XinArkh/Machine_Design_Project/说明及报告/减速器-武鑫.docx

浙江大学课程设计

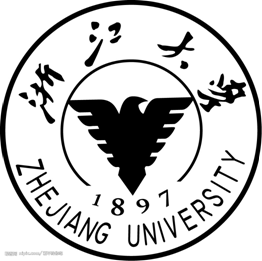
[picture p1: figure]
图片3

课程名称： | 机械设计课程设计（甲）
学生姓名： | 武 鑫
专 业： | 机械电子工程
学 号： | 315010xxxx

2018.03—04

# 1、 设计任务书

## (1) 目标

设计一用于胶带输送机卷筒的传动装置。

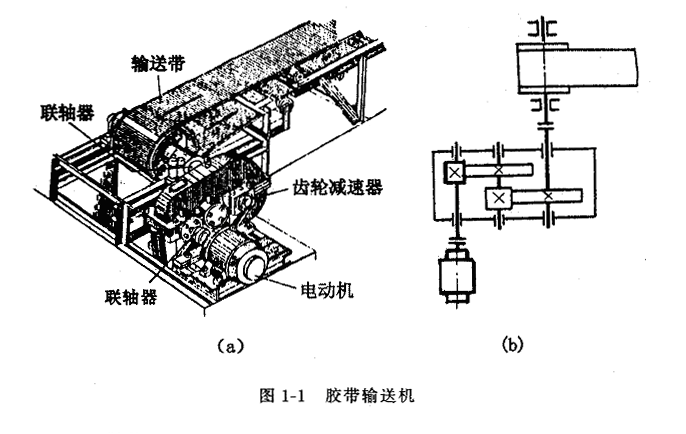
[picture p2: figure]
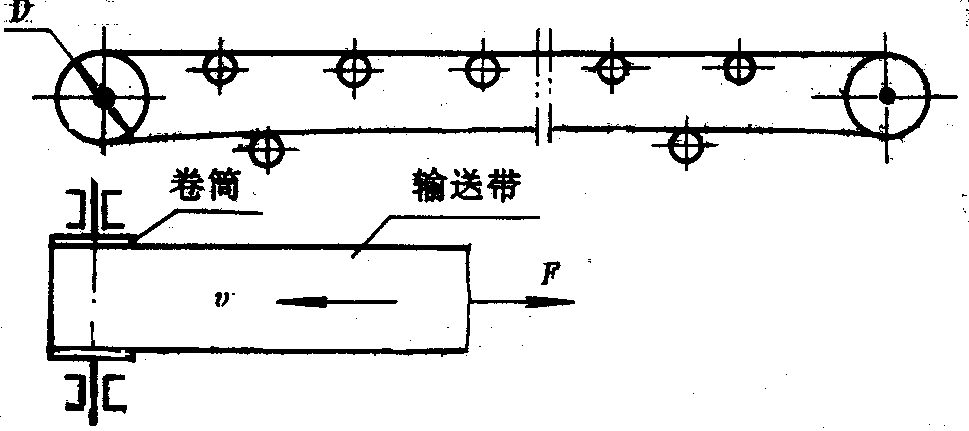
[picture p3: figure]

## (2) 原始条件和数据

输送机两班连续单向运转，载荷平稳，空载启动，室内工作，有粉尘；使用期限10年，大修期3年。该机动力来源为三相交流电，在中等规模机械厂小批量生产。输送带允许速度误差为±5％。

输送带工作拉力2400N，输送带速度1.2m/s，卷筒直径300mm。

# 2、 整体分析与思路

一般的工作机通常由原动机、传动装置和工作装置三个基本部分组成。设计一个用于传送带工作轴的转的装置，即是为电动机和输送机设计一个减速装置。

实现两回转轴之间传动的常用机构有很多种，譬如普通平带、V带传动，链传动，普通齿轮转动，涡轮蜗杆传动以及行星轮传动等。不同的方案又有不同的特点，以实现不同的工作需求。譬如带传动可以实现大跨度的传动，但承载能力较差；链传动平均传动比准确，但运转不均匀，有冲击；涡轮蜗杆传动比大，但承载能力及效率均不如齿轮等等。

在本减速器的设计方案中，选择了两级齿轮传动的传动方案。对于两级齿轮的传动方案，在齿轮布置的型式上也有很多选择，如展开式、分流式、同轴线式等。

本减速器参考了《机械设计课程设计（第四版）》的相关内容，选用两级展开式齿轮减速器，是两级减速器中应用最为广泛的一种。其中齿轮相对于轴承不对称，因此要求轴具有较大的刚度，伸出轴上的齿轮常布置在远离伸出轴的一边，以减少因弯曲变形所引起的载荷沿齿宽分布不均匀现象，输入轴与输出轴分布于减速器的两边。减速器高速级使用一对斜齿轮，低速级使用一对直齿轮，用于载荷较为平稳的场合，以达到减速传动的要求。

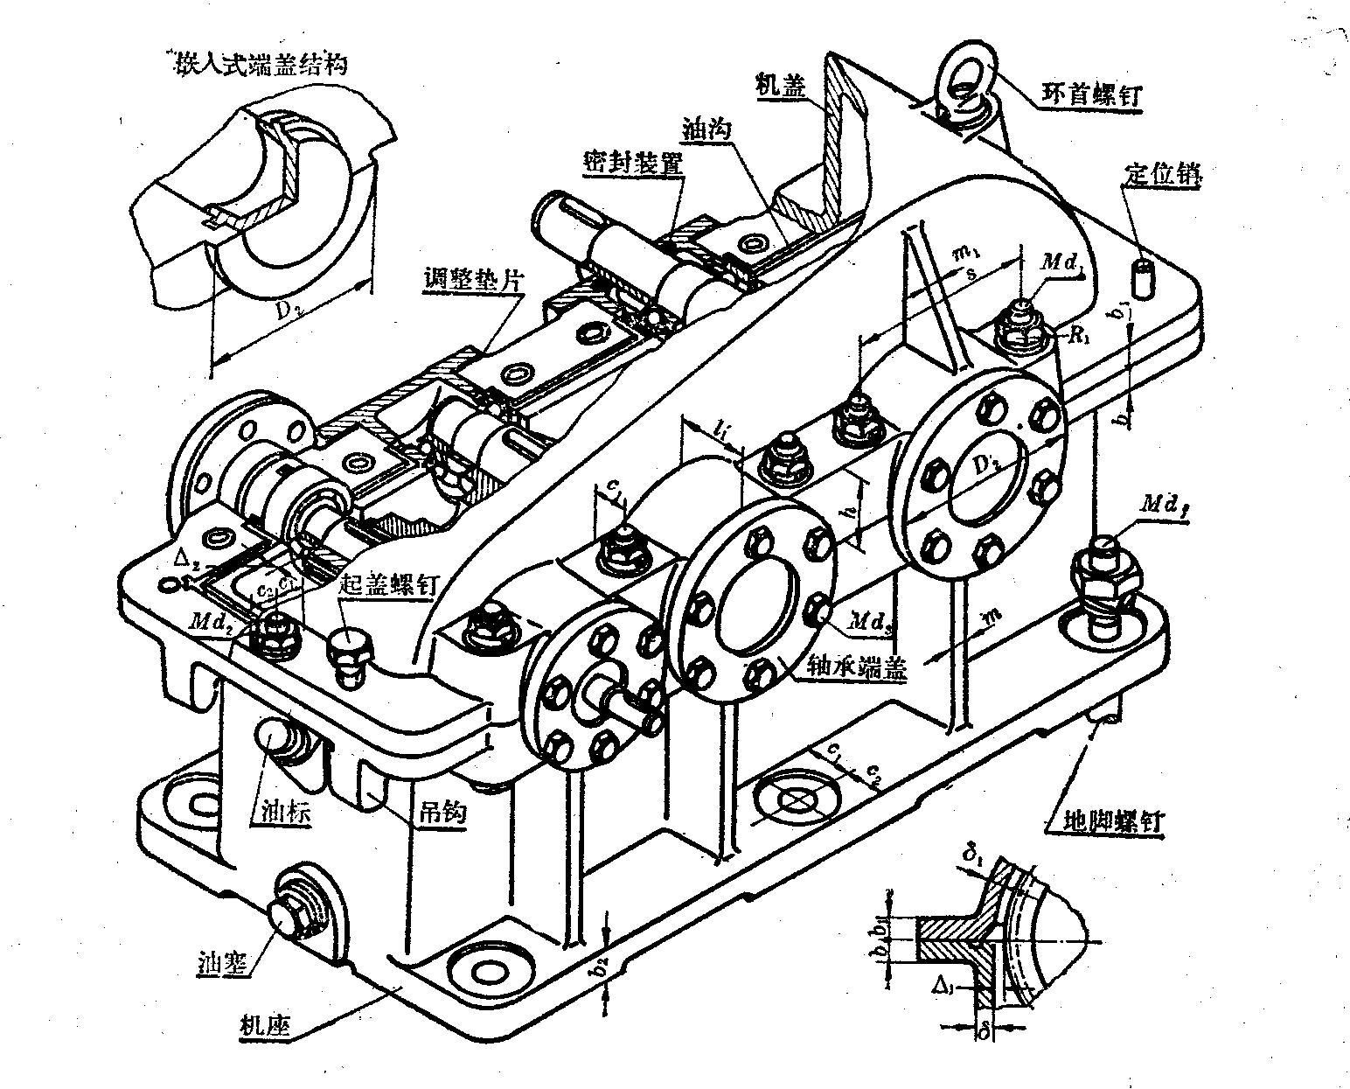
[picture p4: figure]

# 3、 设计说明书

设计内容 | 计算及说明 | 结果
| (1) 传动方案设计

### 1.布局

### 2.选择电动机

（1）选择电动机类型

（2）确定电动机功率，选择型号

### 3．传动比计算与分配

（1）总传动比

（2）分配各级传动比

### 4.计算传动装置的运动和动力参数

（1）各轴转速

（2）各轴输入功率

（3）各轴输入转矩

采用二级圆柱齿轮减速器。

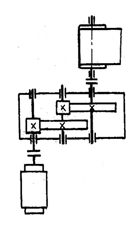
[picture p5: figure]

题设条件中得知，点击动力来源为三相交流电，则采用Y系列三相交流异步电机。

传动带平带开式传动效率为 η_带 =0.98 ，联轴器效率定为 η_联 =0.99 ，（一对）轴承的效率定为 η_轴 =0.99 ，8级精度的一般齿轮传动（稀油润滑）效率为 η_轮 =0.97 。

η_w =η_带 ×η_联 =0.97

P_w =(F_w ·v_w)/(1000η_w)=2.97 kW

η=η_联^2 ×η_轴^3 ×η_轮^2 =0.89

P_0 =(P_w)/η=3.32 kW

常用电动机同步转速有1000r/min和1500r/min两种，考虑到转速较小，可以是传动比较小，从而减小减速其整体尺寸，选用同步转速1000r/min的电动机。

查[2]表8-184知，符合条件的电动机中最合适的型号为Y132M1-6，其相关参数如下表所示：

型号 | Y132M1-6
额定功率（kW） | 4.0
同步转速（r/min） | 1000
满载转速（r/min） | 960
堵转转矩/额定转矩 | 2.0
最大转矩/额定转矩 | 2.2
质量（kg） | 73
转轴直径（mm） | 38

n_w =(v_w)/(π·D)=76.39 r/min

i=(n_m)/(n_w)=12.57

查表知，普通齿轮传动比一般为3~5，则所选两级展开式圆柱齿轮减速器可以满足转动比要求。

i=i_f ×i_s ，为使减速器外廓尺寸协调，相差不悬殊，试取 i_s =3 ，则 i_f =i/(i_s)=4.19 。验证 (i_f)/(i_s)=1.40 ，满足 i_f ≈(1.3~1.6)i_s ，分配合理。

两联轴器处 i_(0-I) =1 ， i_(III-w) =1 。

n_I =(n_m)/(i_(0-I))=960 r/min

n_(II) =(n_I)/(i_(I-II))=229.12 r/min

n_(III) =(n_(II))/(i_(II-III))=76.37 r/min

n_w =(n_(III))/(i_(III-w))=76.37 r/min

P_I =P_0 ·η_(0-I) =P_0 ·η_联 =3.29 kW

P_(II) =P_I ·η_(I-II) =P_I ·η_轴 ·η_轮 =3.16 kW

P_(III) =P_(II) ·η_(II-III) =P_(II) ·η_轴 ·η_轮 =3.03 kW

P_w =P_(III) ·η_(III-w) =P_(III) ·η_轴 ·η_联 =2.97 kW

T_0 =9550(P_0)/(n_m)=33.03 N·m

T_I =9550(P_I)/(n_I)=32.73 N·m

T_(II) =9550(P_(II))/(n_(II))=131.71 N·m

T_(III) =9550(P_(III))/(n_(III))=378.90 N·m

T_w =9550(P_w)/(n_w)=371.40 N·m

将以上算得的运动和动力参数列表如下：

采用Y系列三相交流异步电机

η_带 =0.98

η_联 =0.99

η_轴 =0.99

η_轮 =0.97

η_w =0.97

P_w =2.97 kW

η=0.89

P_0 =3.32 kW

选择额定功率P=4.0kW的电机，型号为Y132M1-6

n_w =76.39 r/min

i=12.57

i_f =4.19

i_s =3

i_(0-I) =1

i_(III-w) =1

n_I =960 r/min

n_(II) =229.12 r/min

n_(III) =76.37 r/min

n_w =76.37 r/min

P_I =3.29 kW

P_(II) =3.16 kW

P_(III) =3.03 kW

P_w =2.97 kW

T_0 =33.03 N·m

T_I =32.73 N·m

T_(II) =131.71 N·m

T_(III) =378.90 N·m

T_w =371.40 N·m

轴名 参数 | 电动机轴 | I轴 | | II轴 | | III轴 | | 工作轴
转速n（r/min） | 960 | 960 | | 229.12 | | 76.37 | | 76.37
功率P（kW） | 3.32 | 3.29 | | 3.16 | | 3.03 | | 2.97
转矩T（N·m） | 33.03 | 32.73 | | 131.71 | | 378.90 | | 371.40
传动比i | 1 | | 4.19 | | 3 | | 1
效率 η | 0.99 | | 0.96 | | 0.96 | | 0.98
| (2) 齿轮传动设计计算

### 1.高速级齿轮传动设计

（1）齿轮材料选择

（2）按齿面接触强度设计公式计算

1 小齿轮传递的转矩
2 选择齿轮齿数
3 确定齿轮精度
4 系数选择
5 确定许用接触应力
6 计算小齿轮分度圆直径
7 计算中心距
8 计算螺旋角及模数
9 计算齿轮主要尺寸
10 验算圆周速度

（3）按齿面弯曲强度校核公式校核

1 确定复合齿形系数
2 确定许用弯曲应力
3 校核齿面弯曲强度

（4）结构设计

### 2.低速级齿轮传动设计

（1）齿轮材料选择

（2）按齿面接触强度设计公式计算

1 小齿轮传递的转矩
2 选择齿轮齿数
3 确定齿轮精度
4 系数选择
5 确定许用接触应力
6 计算小齿轮分度圆直径
7 计算中心距
8 计算螺旋角及模数
9 计算齿轮主要尺寸
10 验算圆周速度

（3）按齿面弯曲强度校核公式校核

1 确定复合齿形系数
2 确定许用弯曲应力
3 校核齿面弯曲强度

（4）结构设计

考虑到减速器传动平稳性，高速级、低速级齿轮均采用斜齿圆柱齿轮。

小齿轮采用40MnB钢调质，大齿轮采用45钢正火。查阅[2]表6-5，得到两齿轮材料主要力学性能如下：

材料牌号 | 热处理方法 | 抗拉强度 σ_B (MPa) | 屈服极限 σ_s (MPa) | 硬度（HBS）
40MnB | 调质 | 735 | 490 | 241~286
45 | 正火 | 588 | 294 | 169~217

由于两齿轮齿面硬度范围均小于350HBS，即均属于软齿面齿轮，根据软齿面闭式齿轮传动中一般为齿面点蚀失效的特点，选择先按照齿面接触强度条件确定主要参数和传动尺寸，然后再按弯曲强度条件进行校核计算。

一对钢齿轮接触强度的设计公式：

d_1 ≥³√(（590/([σ])）^2 ·(u+1)/u·(KT_1)/(ψ_d)) (mm)

已求得

T_1 =32.73 (N·m)=32730 (N·mm)

齿数比 u=i_f =4.19 ，小齿轮齿数 z_1 =21 时， z_2 =uz_1 =88 ，恰好都是整数。

普通减速齿轮，精度选择8级，参考[2]表6-4，圆周速度不得大于 8 m/s 。

载荷平稳，非对称分布，参考[2]表6-6，载荷综合系数 K=1.3 ，参考[2]表6-9，齿宽系数 ψ_d =0.9 。

高速级齿轮的许用应力的数值大小应该是一对齿轮中较小的许用应力值。

许用应力计算公式：

[σ_H ]=(σ_(Hlim))/(S_(Hmin))

参考[2]图6-28， σ_(Hlim1) =720MPa, σ_(Hlim2) =460MPa ；

参考[2]表6-8， S_(Hmin) =1 。

将查得数据代入上式，得 [σ_(H1) ]=720MPa, [σ_(H2) ]=460MPa ，所以 [σ_H ]=[σ_(H1) ]=460MPa 。

d_1 ≥³√(（590/460）^2 ·(4.19+1)/4.19·(1.3×32730)/0.9)=45.84 (mm)

按照 d_1 =45.84 mm 初步计算中心距a：

a=(d_1)/2(1+u)=118.95 (mm)

对结果进行圆整，取 a=120 mm 。

螺旋角 β 常取 8°~20° ，这里初取 β=15° 。

齿轮模数：

m_n =(2acosβ)/(z_1 +z_2)=2.1268 (mm)

参考[2]表6-1，圆整取 m_n =2 mm 。

计算螺旋角 β ：

β=arccos(m_n (z_1 +z_2 ))/(2a)=24.72°

经多次尝试，发现在当前条件下很难找到 8°~20° 范围内的 β 角，经顾大强老师确认，考虑到 24.72° 没有偏离理想值太远，认为该值有效。最终选定 m_n =2 mm ， β=24.72° 。

分度圆直径：

d_1 =(m_n z_1)/(cosβ)=46.237 (mm)

d_2 =(m_n z_2)/(cosβ)=193.763 (mm)

中心距：

a=1/2(d_1 +d_2 )=120 (mm)

齿轮宽度：

b=ψ_d ·d_1 =41.613 (mm)

小齿轮齿宽比大齿轮齿宽大 5~10 mm ,则取 b_1 =47mm, b_2 =42mm 。强度计算中以 b_2 为准，即b =b_2 。

圆周速度：

v=(πd_1 n_I)/(60×1000)=2.324 (m/s)

满足8级精度的速度要求。

斜齿轮弯曲强度校核公式：

σ_F =(1.6KT_1 Y_(Fs))/(bd_1 m_n)≤[σ_F ] (MPa)

小齿轮：

z_(v1) =(z_1)/(cos^3 β)=28.02

大齿轮：

z_(v2) =(z_2)/(cos^3 β)=117.41

由[2]图6-30查得复合齿形系数 Y_(Fs1) =4.20, Y_(Fs2) =3.92 。

由[2]图6-31查得 σ_(Flim1) =530MPa ， σ_(Flim2) =360MPa 。

由[2]表6-8查得 S_(Fmin) =1 ，则：

[σ_(F1) ]=(σ_(Flim1))/(S_(Fmin))=530 (MPa)

[σ_(F2) ]=(σ_(Flim2))/(S_(Fmin))=360 (MPa)

σ_(F1) =(1.6KT_1 Y_(Fs1))/(bd_1 m_n)=73.62<[σ_(F1) ]=530 (MPa)

σ_(F2) =σ_(F1) (Y_(Fs2))/(Y_(Fs1))=68.71<[σ_(F2) ]=360 (MPa)

校核计算安全。

小齿轮做成齿轮轴；大齿轮做成腹板式齿轮，采用锻造齿轮。

同样选择40MnB调质钢和45正火钢作为小齿轮和大齿轮的材质，相关力学性能同高速级部分表格所示。

先按照齿面接触强度条件确定主要参数和传动尺寸，然后再按弯曲强度条件进行校核计算，理由同高速级部分。

一对钢齿轮接触强度的设计公式：

d_1 ≥³√(（590/([σ])）^2 ·(u+1)/u·(KT_1)/(ψ_d)) (mm)

已求得

T_1 =131.71(N·m)=131710 (N·mm)

齿数比 u=i_s =3 ，选择小齿轮齿数 z_1 =24 ， z_2 =uz_1 =72 。

普通减速齿轮，精度选择8级，参考[2]表6-4，圆周速度不得大于 8 m/s 。

载荷平稳，非对称分布，参考[2]表6-6，载荷综合系数 K=1.3 ，参考[2]表6-9，齿宽系数 ψ_d =0.9 。

低速级齿轮的许用应力的数值大小应该是一对齿轮中较小的许用应力值。

许用应力计算公式：

[σ_H ]=(σ_(Hlim))/(S_(Hmin))

参考[2]图6-28， σ_(Hlim1) =720MPa, σ_(Hlim2) =460MPa ；

参考[2]表6-8， S_(Hmin) =1 。

将查得数据代入上式，得 [σ_(H1) ]=720MPa, [σ_(H2) ]=460MPa ，所以 [σ_H ]=[σ_(H1) ]=460MPa 。

d_1 ≥³√(（590/460）^2 ·(3+1)/3·(1.3×131710)/0.9)=74.73 (mm)

按照 d_1 =74.73 mm 初步计算中心距a：

a=(d_1)/2(1+u)=149.46 (mm)

对结果进行圆整，取 a=150 mm 。

螺旋角 β 常取 8°~20° ，这里初取 β=15° 。

齿轮模数：

m_n =(2acosβ)/(z_1 +z_2)=3.0185 (mm)

参考[2]表6-1，圆整取 m_n =3 mm 。

计算螺旋角 β ：

β=arccos(m_n (z_1 +z_2 ))/(2a)=16.26°

分度圆直径：

d_1 =(m_n z_1)/(cosβ)=75.000 (mm)

d_2 =(m_n z_2)/(cosβ)=225.000 (mm)

中心距：

a=1/2(d_1 +d_2 )=150 (mm)

齿轮宽度：

b=ψ_d ·d_1 =67.50 (mm)

小齿轮齿宽比大齿轮齿宽大 5~10 mm ,则取 b_1 =73mm, b_2 =68mm 。强度计算中以 b_2 为准，即b =b_2 。

圆周速度：

v=(πd_1 n_(II))/(60×1000)=0.900 (m/s)

满足8级精度的速度要求。

斜齿轮弯曲强度校核公式：

σ_F =(1.6KT_1 Y_(Fs))/(bd_1 m_n)≤[σ_F ] (MPa)

小齿轮：

z_(v1) =(z_1)/(cos^3 β)=27.13

大齿轮：

z_(v2) =(z_2)/(cos^3 β)=81.38

由[2]图6-30查得复合齿形系数 Y_(Fs1) =4.10, Y_(Fs2) =3.93 。

由[2]图6-31查得 σ_(Flim1) =530MPa ， σ_(Flim2) =360MPa 。

由[2]表6-8查得 S_(Fmin) =1 ，则：

[σ_(F1) ]=(σ_(Flim1))/(S_(Fmin))=530 (MPa)

[σ_(F2) ]=(σ_(Flim2))/(S_(Fmin))=360 (MPa)

σ_(F1) =(1.6KT_1 Y_(Fs1))/(bd_1 m_n)=73.41<[σ_(F1) ]=530(MPa)

σ_(F2) =σ_(F1) (Y_(Fs2))/(Y_(Fs1))=70.37<[σ_(F2) ]=360(MPa)

校核计算安全。

小齿轮做成齿轮轴；大齿轮做成腹板式齿轮，采用锻造齿轮。

小齿轮：40MnB钢调质

大齿轮：45钢正火

u=i_f =4.19

z_1 =21

z_2 =88

K=1.3

ψ_d =0.9

[σ_H ]=460MPa

d_1 ≥45.84 mm

m_n =2 mm

β=24.72°

d_1 =46.237 mm

d_2 =193.763 mm

a=120 mm

b_1 =47 mm

b=b_2 =42 mm

v=2.324 m/s

z_(v1) =28.02

z_(v2) =117.41

Y_(Fs1) =4.20

Y_(Fs2) =3.92

[σ_(F1) ]=530 MPa

[σ_(F2) ]=360 MPa

σ_(F1) <[σ_(F1) ]

σ_(F2) <[σ_(F2) ]

安全

齿轮1：齿轮轴

齿轮2：锻造腹板式齿轮

小齿轮：40MnB钢调质

大齿轮：45钢正火

u=i_s =3

z_1 =24

z_2 =72

K=1.3

ψ_d =0.9

[σ_H ]=460MPa

d_1 ≥74.73 mm

m_n =3 mm

β=16.26°

d_1 =75.000 (mm)

d_2 =225.000 (mm)

a=150 (mm)

b_1 =73mm

b=b_2 =68mm

v=0.900 m/s

z_(v1) =27.13

z_(v2) =81.38

Y_(Fs1) =4.10

Y_(Fs2) =3.93

[σ_(F1) ]=530 MPa

[σ_(F2) ]=360 MPa

σ_(F1) <[σ_(F1) ]

σ_(F2) <[σ_(F2) ]

安全

齿轮3：锻造腹板式齿轮

齿轮4：锻造腹板式齿轮
| (3) 轴的结构设计计算及校核

### 1. 齿轮受力计算

（1）高速级

齿轮1

（2）低速级齿轮4

（3）中间级齿轮2、3

### 2. 中间轴结构设计计算及校核

（1）轴的材料选择

（2）按转矩估算最小直径

（3）轴的结构设计

1 轴承选择
2 轴的轴向尺寸确定

（4）轴承反力计算

（5）绘制弯矩图

1 水平弯矩图
2 垂直弯矩图
3 合成弯矩图

（6）绘制扭矩图

（7）绘制当量弯矩图

（8）校核危险截面处直径

（9）精确校核轴的疲劳强度

### 3. 高速轴结构设计计算及校核

（1）轴的材料选择

（2）按转矩估算最小直径

3）轴的结构设计

1 轴承选择
2 轴的轴向尺寸确定

（4）轴承反力计算

（5）绘制弯矩图

1 水平弯矩图
2 垂直弯矩图
3 合成弯矩图

（6）绘制扭矩图

（7）绘制当量弯矩图

（8）校核危险截面处直径

（9）精确校核轴的疲劳强度

### 4. 低速轴结构设计计算及校核

（1）轴的材料选择

（2）按转矩估算最小直径

3）轴的结构设计

1 轴承选择
2 轴的轴向尺寸确定

（4）轴承反力计算

（5）绘制弯矩图

1 水平弯矩图
2 垂直弯矩图
3 合成弯矩图

（6）绘制扭矩图

（7）绘制当量弯矩图

（8）校核危险截面处直径

（9）精确校核轴的疲劳强度

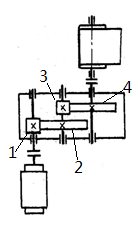
[picture p6: figure]

圆周力：

F_(t1) =(2T_I)/(d_1)=1.416(kN)

径向力：

F_(r1) =(F_(t1) tanα)/(cosβ)=0.567(kN)

轴向力：

F_(a1) =F_(t1) tanβ=0.652(kN)

F_(t4) =(2T_(III))/(d_4)=3.368(kN)

F_(r4) =(F_(t4) tanα)/(cosβ)=1.277(kN)

F_(a4) =F_(t4) tanβ=0.982(kN)

齿轮2：

F_(t2) =F_(t1) =1.416(kN)

F_(r2) =F_(r1) =0.567(kN)

F_(a2) =F_(a1) =0.652(kN)

齿轮3：

F_(t3) =F_(t4) =3.368(kN)

F_(r3) =F_(r4) =1.277(kN)

F_(a3) =F_(a4) =0.982(kN)

减速器功率不大，转速较低，无特殊要求，故选最常用的45号钢并做正火处理。

根据[2]表12-1查得：

硬度（HBS） | 170~217
抗拉强度 σ_B (MPa) | 600
屈服极限 σ_S (MPa) | 300
弯曲疲劳极限 σ_(-1) (MPa) | 240
剪切疲劳极限τ_(-1) (MPa) | 140

根据[2]表12-2，取 C=118 ，代入公式：

d≥C³√(P/n)=28.298(mm)

考虑到键槽对轴的削弱作用，圆整为 d_(min) =30mm 。

根据估算所得直径、轮毂宽及安装情况等条件，对轴的结构及尺寸进行草图设计。

轴承同时承受径向力和轴向力，采用一对角接触球轴承；考虑到轴承内径需不小于 d_(min) =30mm 。查[2]表8-158，选择7207AC型（GB/T292-1994）角接触球轴承，其主要几何参数如下：

内径d（mm） | 外径D（mm） | 宽度B（mm）
35 | 72 | 17

两端的轴承都用套筒定位和固定。

轴与齿轮选用平键连接。根据减速器的内壁到齿轮和轴承端面的距离，参考设计手册中有关经验数据，轴承跨距为160mm,将轴的结构尺寸初步取定如图所示：

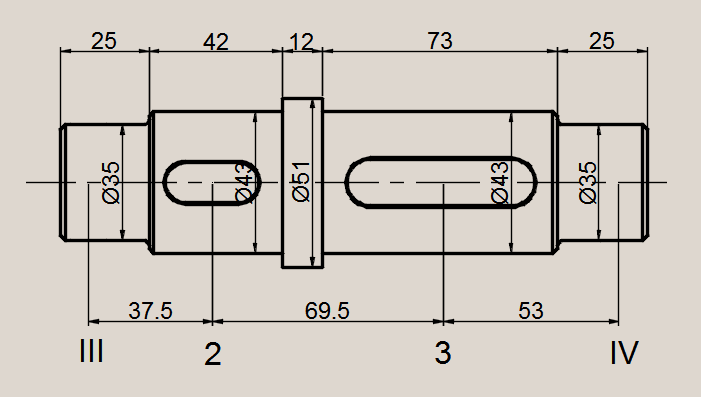
[picture p7: figure]

水平面：

R_(IIIH) =(-F_(a2) (d_2)/2+122.5F_(r2) -F_(a3) (d_3)/2-53F_(r3))/160=-0.614(kN)

R_(IVH) =(F_(a3) (d_3)/2-107F_(r3) +F_(a2) (d_2)/2+37.5F_(r2))/160=-0.096(kN)

垂直面：

R_(IIIV) =(122.5F_(t2) +53F_(t3))/160=2.200(kN)

R_(IVV) =(107F_(t3) +37.5F_(t2))/160=2.584(kN)

M_(2H)^(') =37.5R_(IIIH) =-23.019(N·m)

M_(2H)^('') =69.5F_(r3) -F_(a3) (d_3)/2+122.5R_(IVH) =40.148(N·m)

M_(3H)^(') =53R_(IVH) =-5.096(N·m)

M_(3H)^('') =-69.5F_(r2) +F_(a2) (d_2)/2+107R_(IIIH) =-41.921(N·m)

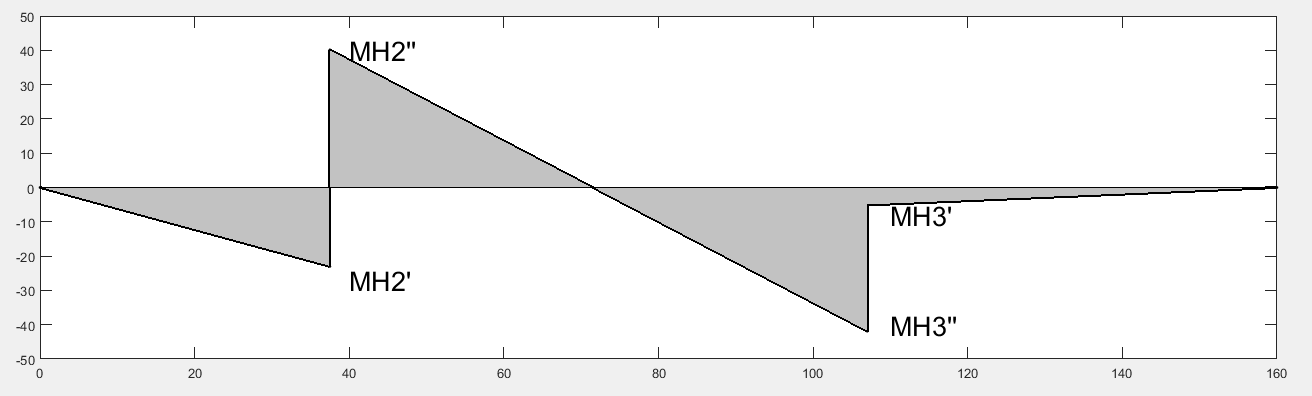
[picture p8: figure]

M_(2V) =37.5R_(IIIV) =82.492(N·m)

M_(3V) =53R_(IVV) =136.964(N·m)

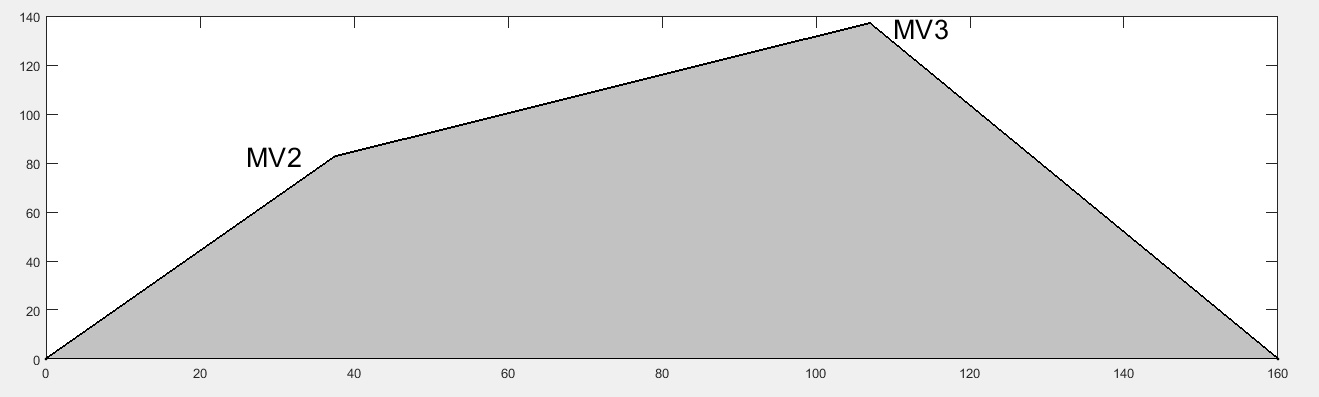
[picture p9: figure]

M_2^(') =√(M_(2H)^(') ^2 +M_(2V)^() ^2)=85.643(N·m)

M_2^('') =√(M_(2H)^('') ^2 +M_(2V)^() ^2)=91.742(N·m)

M_3^(') =√(M_(3H)^(') ^2 +M_(3V)^() ^2)=137.059(N·m)

M_3^('') =√(M_(3H)^('') ^2 +M_(3V)^() ^2)=143.236(N·m)

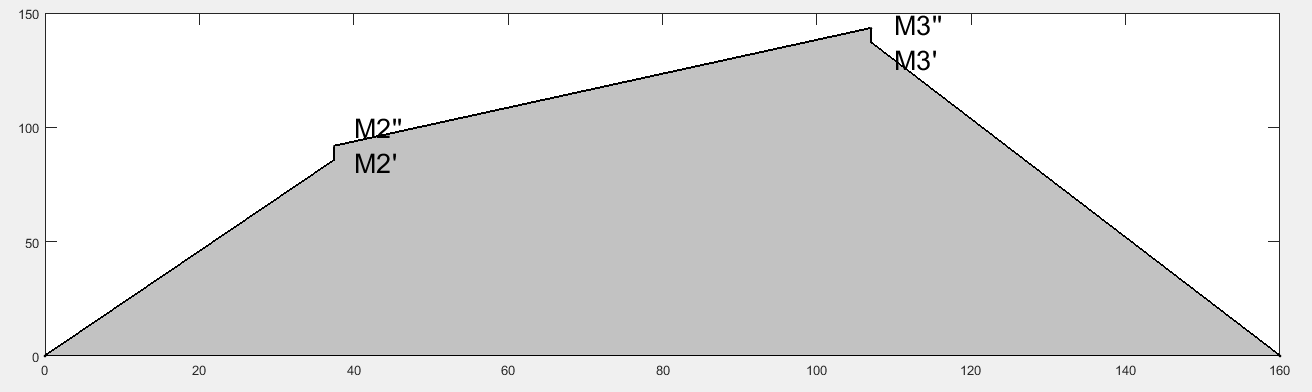
[picture p10: figure]

已求得轴II所受扭矩 T_2 =131.71N·m 。

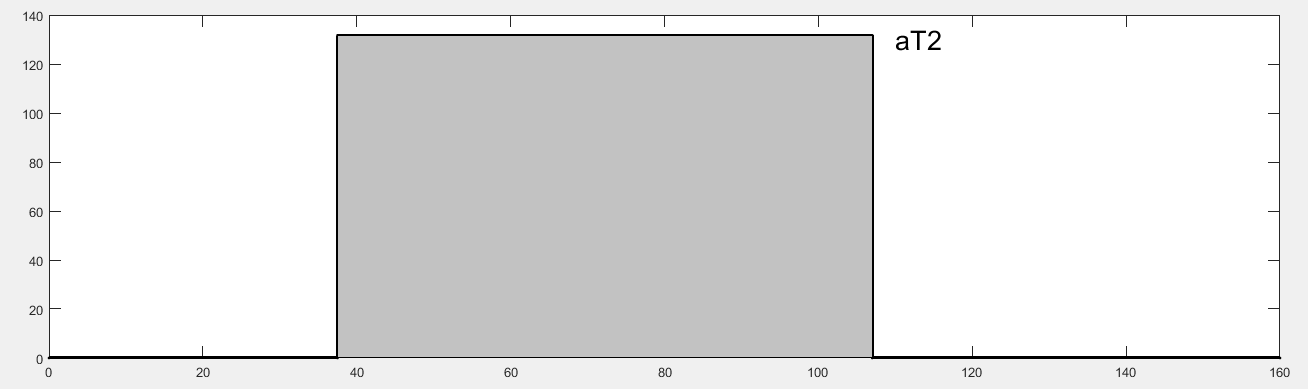
[picture p11: figure]

已知 σ_B =600MPa ，由[2]表12-3查得 [σ_(-1) ]_b =55MPa ， [σ_0 ]_b =95MPa ，则 α=55/95≈0.58 。

αT_2 =76.392(N·m)

M_(2e)^(') =√(M_2^(') ^2 +(αT_2 )^2)=114.763(N·m)

M_(2e)^('') =√(M_2^('') ^2 +(αT_2 )^2)=119.383(N·m)

M_(3e)^(') =√(M_3^(') ^2 +(αT_2 )^2)=156.910(N·m)

M_(3e)^('') =√(M_3^('') ^2 +(αT_2 )^2)=162.334(N·m)

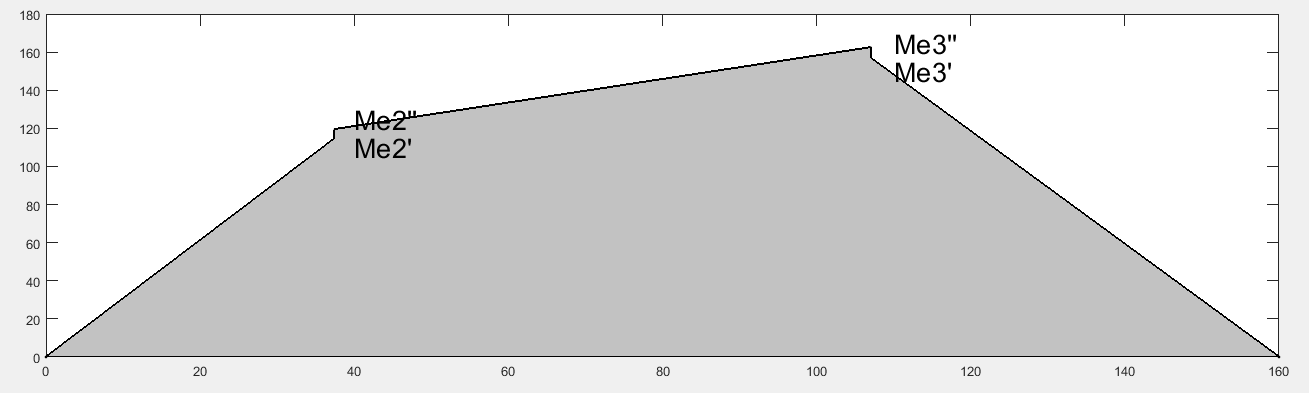
[picture p12: figure]

d_3 ≥³√((M_(3e)^(''))/(0.1[σ_(-1) ]_b))=30.904(mm)

直径条件（35mm）满足要求，强度足够。如所选轴承和键联接等经计算、确认寿命和强度均能满足，则以上轴的结构设计无需修改。

危险截面（齿轮3）处：

σ_a =(M_3^(''))/W=3.460(MPa)

σ_m =0

τ_a =τ_m =T/(2W_T)=0.795(MPa)

轴的弯曲等效系数 ψ_σ =0.2 ，剪切等效系数 ψ_τ =0.1 。

查表[2]12-4得 k_σ =1.76 ， k_τ =1.54 , ε_σ =0.81 ， ε_τ =0.76 。查表[2]12-8得 β=0.95 。取寿命系数 K_N =1 ， [S]=1.5 。

S_σ =(K_N σ_(-1))/((k_σ)/(ε_σ β)σ_a +ψ_σ σ_m)=30.33

S_τ =(K_N τ_(-1))/((k_τ)/(ε_τ β)τ_a +ψ_τ τ_m)=78.82

S=(S_σ S_τ)/(√(S_σ ^2 +S_τ ^2))=28.30>1.5

安全。

减速器功率不大，转速较低，无特殊要求，故选最常用的45号钢并做正火处理。

钢材硬度和相关力学参数已在中间轴部分列出。

根据[2]表12-2，取 C=118 ，代入公式：

d≥C³√(P/n)=17.79(mm)

考虑到键槽对轴的削弱作用，圆整为 d_(min) =20mm 。

根据估算所得直径、轮毂宽及安装情况等条件，对轴的结构及尺寸进行草图设计。

轴承同时承受径向力和轴向力，采用一对角接触球轴承；考虑到轴承内径需不小于 d_(min) =20mm 。查[2]表8-158，选择7205AC型（GB/T292-1994）角接触球轴承，其主要几何参数如下

内径d（mm） | 外径D（mm） | 宽度B（mm）
25 | 52 | 15

一端的轴承用套筒固定，另一端用轴肩固定。

选用齿轮轴。根据减速器的内壁到齿轮和轴承端面的距离，参考设计手册中有关经验数据，轴承跨距为160mm,将轴的结构尺寸初步取定如图所示：

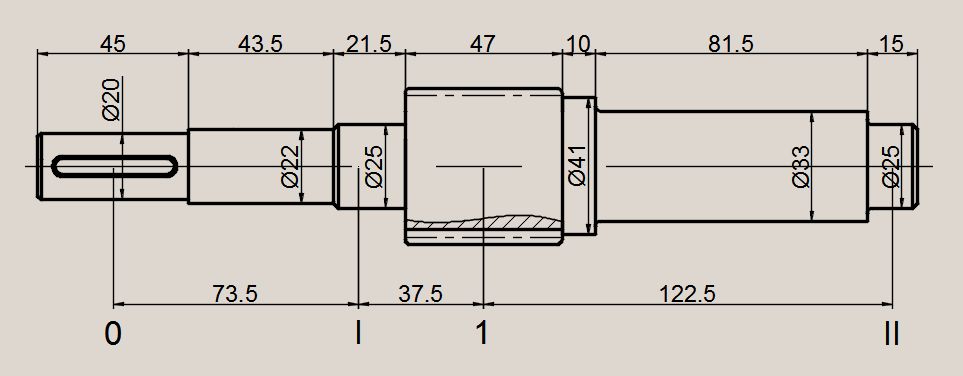
[picture p13: figure]

水平面：

R_(IH) =(F_(a1) (d_1)/2+112.5F_(r1))/160

=0.497(kN)

R_(IIH) =(-F_(a1) (d_1)/2+47.5F_(r1))/160=0.070(kN)

垂直面：

R_(IV) =(-112.5F_(t1))/160=-1.020(kN)

R_(IIV) =(-47.5F_(t1))/160=-0.396(kN)

M_(1H)^(') =47.5R_(IH) =23.619(N·m)

M_(1H)^('') =112.5R_(IIH) =8.546(N·m)

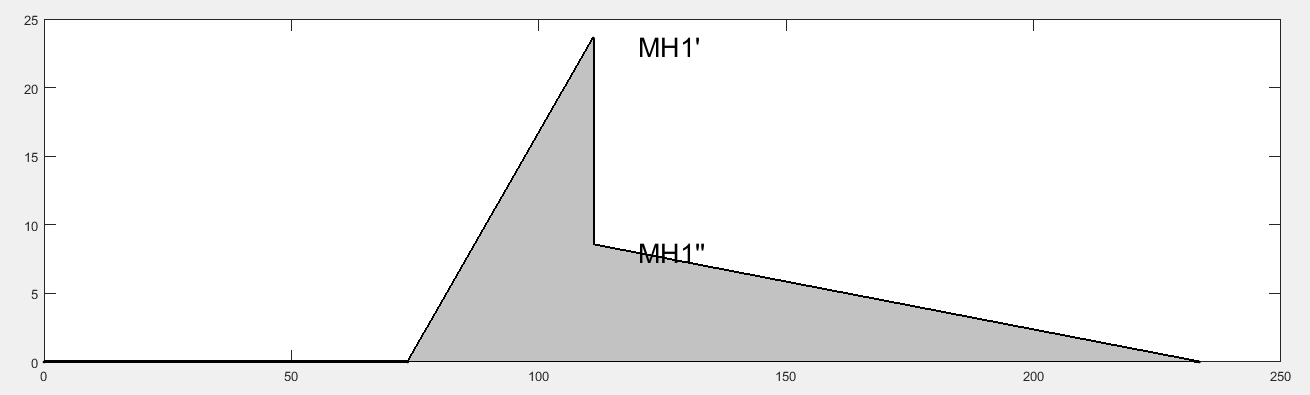
[picture p14: figure]

M_(1V) =47.5R_(IV) =-48.467(N·m)

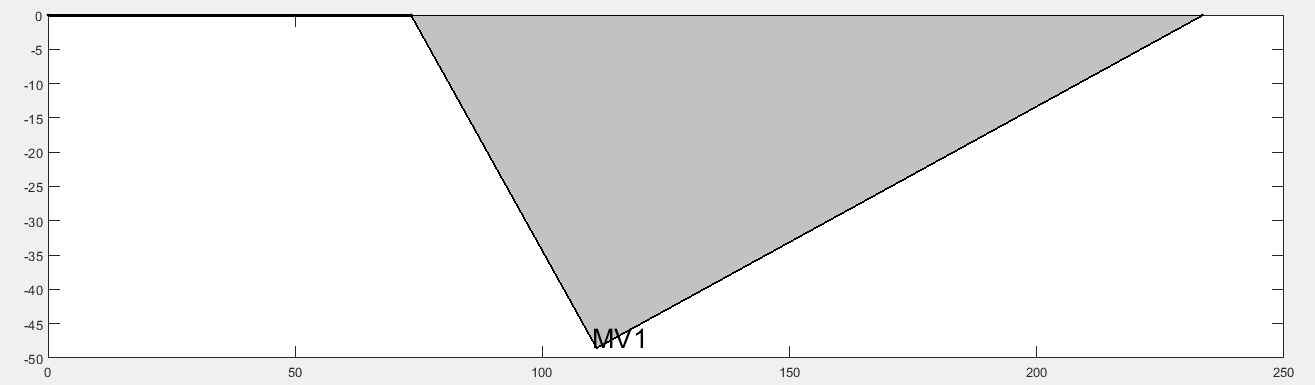
[picture p15: figure]

M_1^(') =√(M_H^(') ^2 +M_V^() ^2)=53.915(N·m)

M_1^('') =√(M_H^('') ^2 +M_V^() ^2)=49.214(N·m)

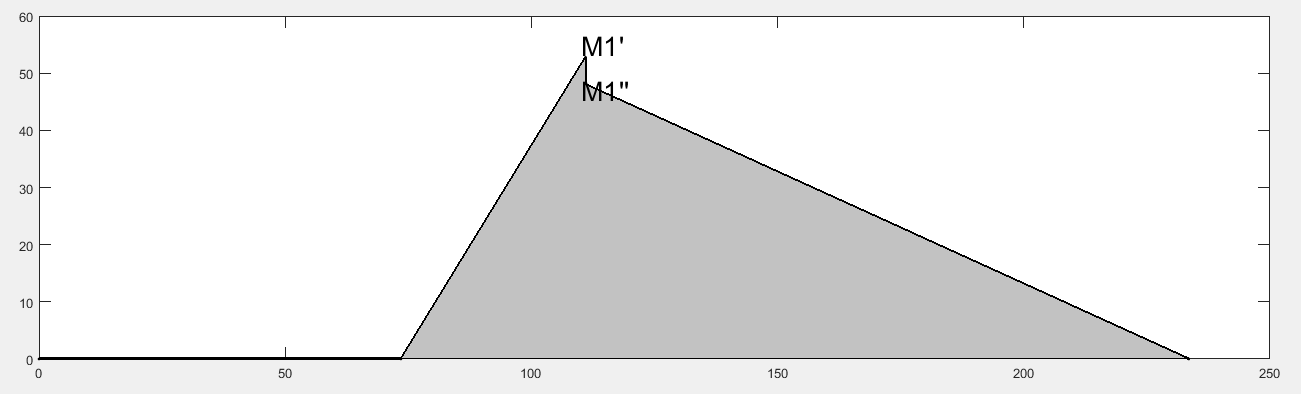
[picture p16: figure]

已求得轴I所受扭矩 T_1 =32.73N·m 。

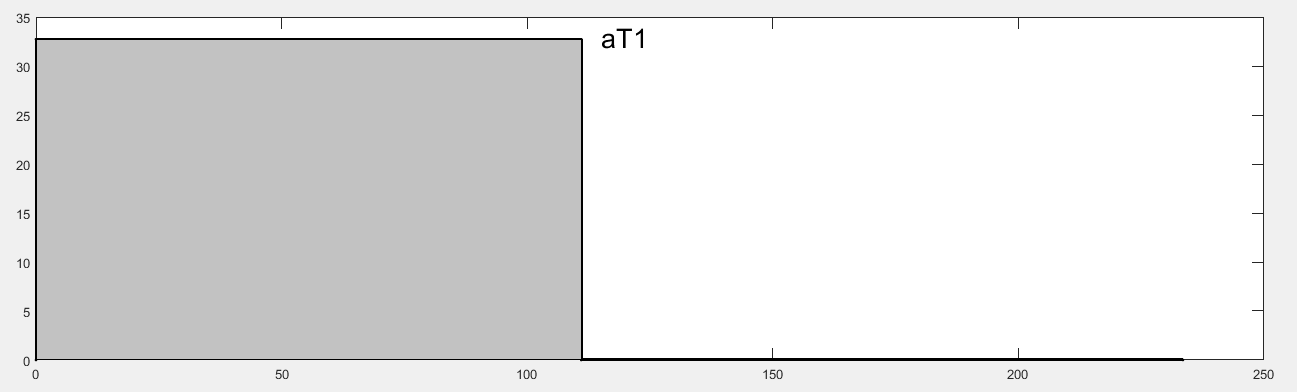
[picture p17: figure]

在中间轴部分已查得 σ_B =600MPa 、 [σ_(-1) ]_b =55MPa 、 [σ_0 ]_b =95MPa ，则 α=55/95≈0.58 。

αT_1 =18.983(N·m)

M_(1e)^(') =√(M_1^(') ^2 +(αT_1 )^2)=57.160(N·m)

M_(1e)^('') =M_1^('') =49.214(N·m)

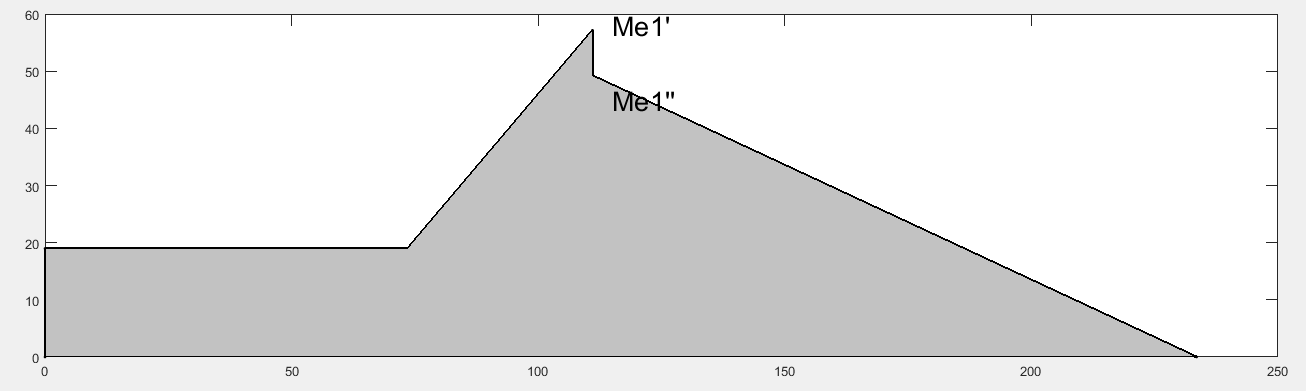
[picture p18: figure]

d_0 ≥³√((M_(0e)^(''))/(0.1[σ_(-1) ]_b))=15.113(mm)

d_1 ≥³√((M_(3e)^(''))/(0.1[σ_(-1) ]_b))=21.685(mm)

直径条件满足要求，强度足够。如所选轴承和键联接等经计算、确认寿命和强度均能满足，则以上轴的结构设计无需修改。

位置0处：

σ_a =σ_m =0

τ_a =τ_m =T/(2W_T)=10.424(MPa)

轴的弯曲等效系数 ψ_σ =0.2 ，剪切等效系数 ψ_τ =0.1 。

在中间轴部分已查得 k_σ =1.76、k_τ =1.54、ε_σ =0.81、ε_τ =0.76、β=0.95 。取寿命系数 K_N =1 ， [S]=1.5 。

S=S_τ =(K_N τ_(-1))/((k_τ)/(ε_τ β)τ_a +ψ_τ τ_m)=6.015>1.5

安全。

齿轮1处：

σ_a =(M_3^(''))/W=5.440(MPa)

σ_m =0

τ_a =τ_m =T/(2W_T)=0.844(MPa)

轴的弯曲等效系数 ψ_σ =0.2 ，剪切等效系数 ψ_τ =0.1 。

在中间轴部分已查得 k_σ =1.76、k_τ =1.54、ε_σ =0.81、ε_τ =0.76、β=0.95 。取寿命系数 K_N =1 ， [S]=1.5 。

S_σ =(K_N σ_(-1))/((k_σ)/(ε_σ β)σ_a +ψ_σ σ_m)=19.29

S_τ =(K_N τ_(-1))/((k_τ)/(ε_τ β)τ_a +ψ_τ τ_m)=74.32

S=(S_σ S_τ)/(√(S_σ ^2 +S_τ ^2))=18.669>1.5

安全。

减速器功率不大，转速较低，无特殊要求，故选最常用的45号钢并做正火处理。

钢材硬度和相关力学参数已在中间轴部分列出。

d≥C³√(P/n)=40.25(mm)

考虑到键槽对轴的削弱作用，圆整为 d_(min) =41mm 。

根据估算所得直径、轮毂宽及安装情况等条件，对轴的结构及尺寸进行草图设计。

轴承同时承受径向力和轴向力，采用一对角接触球轴承；考虑到轴承内径需不小于 d_(min) =41mm 。查[2]表8-158，选择7209AC型（GB/T292-1994）角接触球轴承，其主要几何参数如下：

内径d（mm） | 外径D（mm） | 宽度B（mm）
45 | 85 | 19

一端的轴承用轴肩固定，另一端用套筒固定。

轴与齿轮选用平键连接。根据减速器的内壁到齿轮和轴承端面的距离，参考设计手册中有关经验数据，轴承跨距为160mm,将轴的结构尺寸初步取定如图所示：

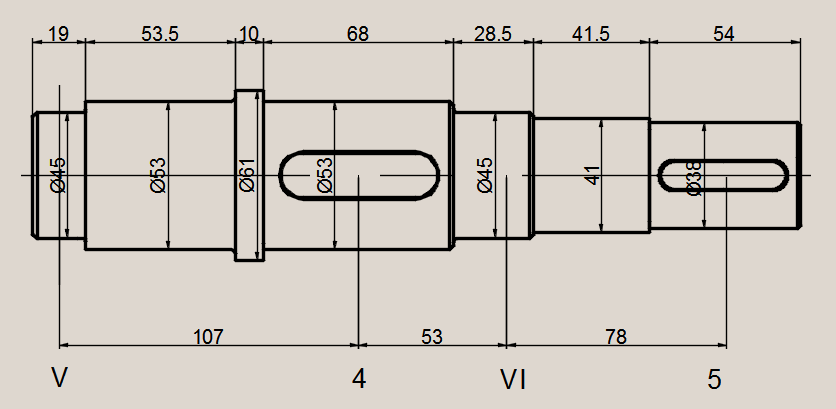
[picture p19: figure]

水平面：

R_(VH) =(-F_(a4) (d_4)/2+53F_(r4))/160=-0.267(kN)

R_(VIH) =(F_(a4) (d_4)/2+107F_(r4))/160=1.544(kN)

垂直面：

R_(VV) =(-53F_(t4))/160=-1.116(kN)

R_(VIV) =(-107F_(t4))/160=-2.252(kN)

M_(4H)^(') =107R_(VH) =-28.619(N·m)

M_(4H)^('') =53R_(VIH) =81.857(N·m)

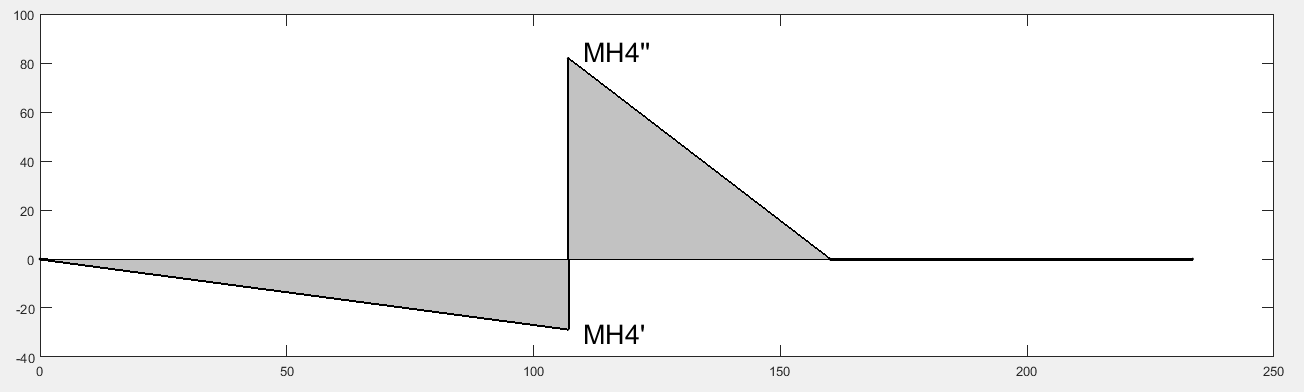
[picture p20: figure]

M_(4V) =107R_(IV) =-119.375(N·m)

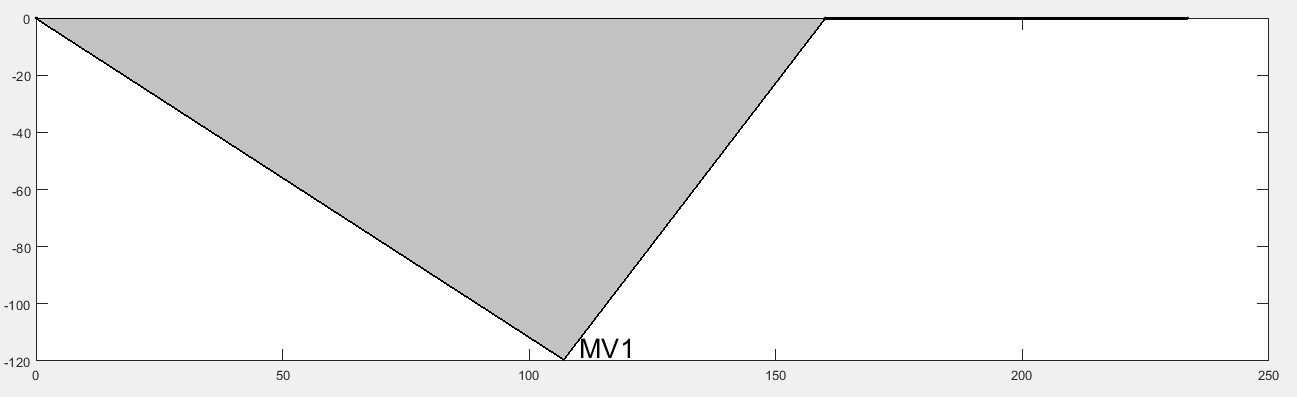
[picture p21: figure]

M_4^(') =√(M_H^(') ^2 +M_V^() ^2)=122.757(N·m)

M_4^('') =√(M_H^('') ^2 +M_V^() ^2)=144.744(N·m)

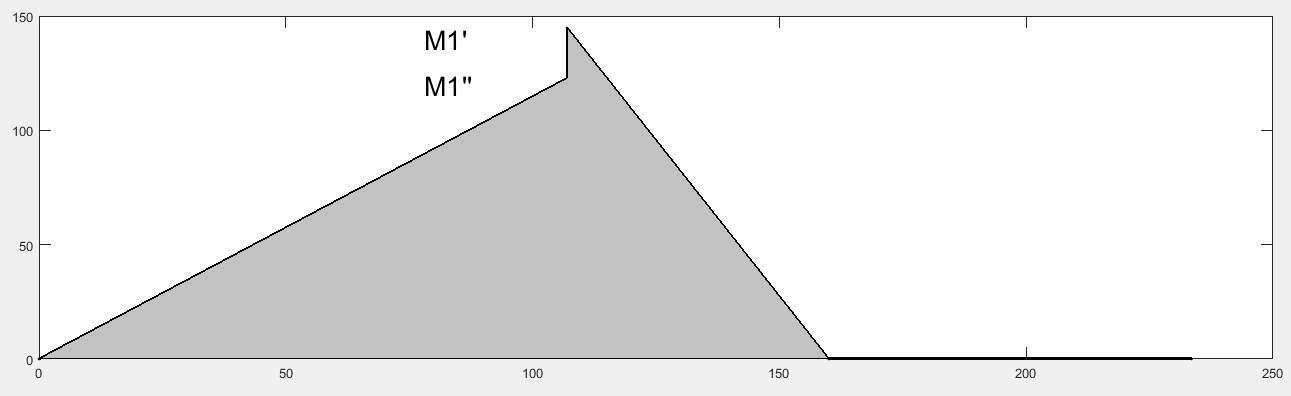
[picture p22: figure]

已求得轴III所受扭矩 T_3 =378.9N·m 。

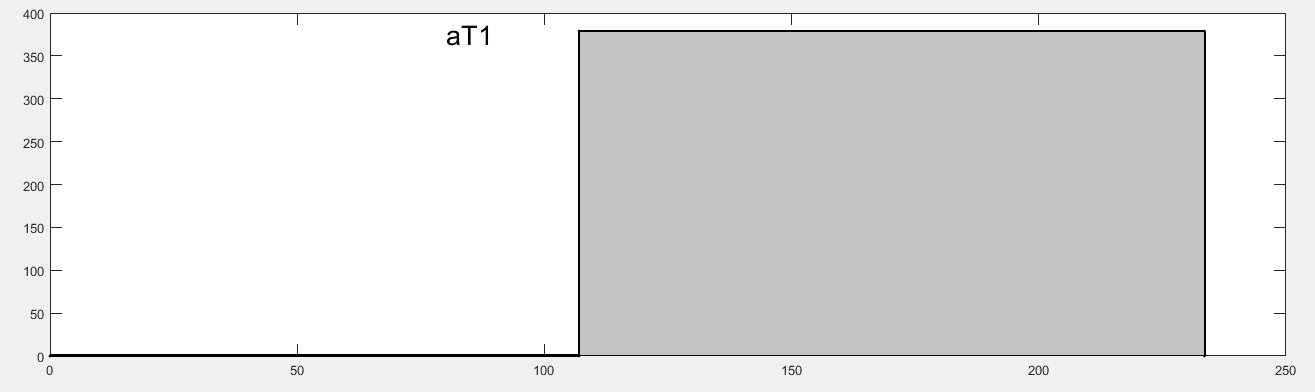
[picture p23: figure]

在中间轴部分已查得 σ_B =600MPa 、 [σ_(-1) ]_b =55MPa 、 [σ_0 ]_b =95MPa ，则 α=55/95≈0.58 。

αT_3 =219.762(N·m)

M_e^(') =M_4^(') =122.757(N·m)

M_e^('') =√(M^('') ^2 +(αT_2 )^2)=263.147(N·m)

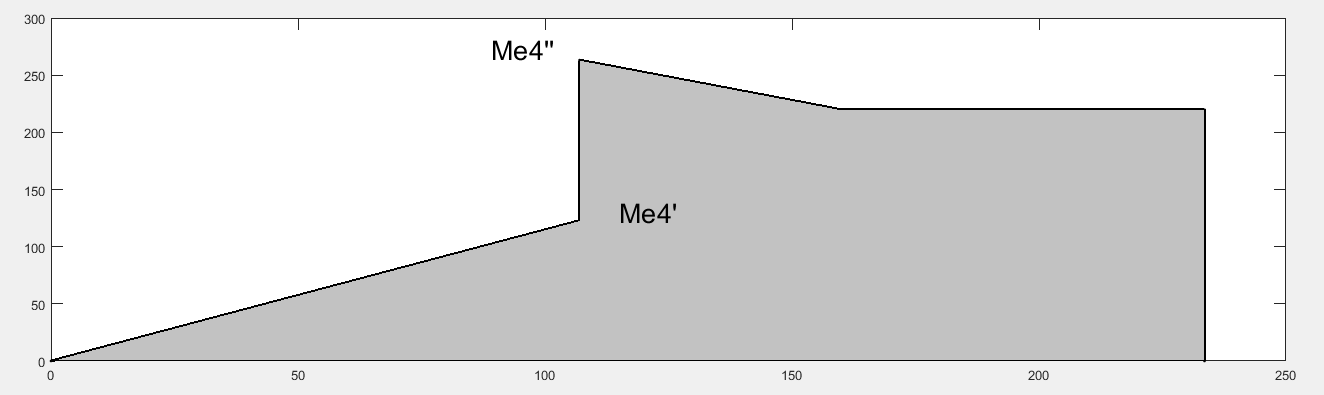
[picture p24: figure]

d_4 ≥³√((M_(3e)^(''))/(0.1[σ_(-1) ]_b))=36.303(mm)

直径条件（45mm）满足要求，强度足够。如所选轴承和键联接等经计算、确认寿命和强度均能满足，则以上轴的结构设计无需修改。

齿轮4处：

σ_a =(M_3^(''))/W=0.130(MPa)

σ_m =0

τ_a =τ_m =T/(2W_T)=12.142(MPa)

轴的弯曲等效系数 ψ_σ =0.2 ，剪切等效系数 ψ_τ =0.1 。

在中间轴部分已查得 k_σ =1.76、k_τ =1.54、ε_σ =0.81、ε_τ =0.76、β=0.95 。取寿命系数 K_N =1 ， [S]=1.5 。

S_σ =(K_N σ_(-1))/((k_σ)/(ε_σ β)σ_a +ψ_σ σ_m)=810.28

S_τ =(K_N τ_(-1))/((k_τ)/(ε_τ β)τ_a +ψ_τ τ_m)=5.16

S=(S_σ S_τ)/(√(S_σ ^2 +S_τ ^2))=5.16>1.5

安全。

位置5处：

σ_a =σ_m =0

τ_a =τ_m =T/(2W_T)=1.754(MPa)

轴的弯曲等效系数 ψ_σ =0.2 ，剪切等效系数 ψ_τ =0.1 。

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

S=S_τ =(K_N τ_(-1))/((k_τ)/(ε_τ β)τ_a +ψ_τ τ_m)1.75>1.5

安全。

F_(t1) =1.416kN

F_(r1) =0.567kN

F_(a1) =0.652kN

F_(t4) =3.368kN

F_(r4) =1.277kN

F_(a4) =0.982kN

F_(t2) =1.416kN

F_(r2) =0.567kN

F_(a2) =0.652kN

F_(t3) =3.368kN

F_(r3) =1.277kN

F_(a3) =0.982kN

中间轴选择45号钢正火

d_(min) =30mm

R_(IIIH) =-0.614kN

R_(IVH) =-0.096kN

R_(IIIV) =2.200kN

R_(IVV) =2.584kN

M_(2H)^(') =-23.019N·m

M_(2H)^('') =40.148N·m

M_(3H)^(') =-5.096N·m

M_(3H)^('') =-41.921N·m

M_(2V) =82.492N·m

M_(3V) =136.964N·m

M_2^(') =85.643N·m

M_2^('') =91.742N·m

M_3^(') =137.059N·m

M_3^('') =143.236N·m

αT_2 =76.392N·m

M_(2e)^(') =114.763N·m

M_(2e)^('') =119.383N·m

M_(3e)^(') =156.910N·m

M_(3e)^('') =162.334N·m

35mm>d_3 ≥30.904mm

危险截面处安全

S=28.30>1.5

安全

d_(min) =20mm

R_(IH) =0.497kN

R_(IIH) =0.070kN

R_(IV) =-1.020kN

R_(IIV) =-0.396kN

M_(1H)^(') =23.619N·m

M_(1H)^('') =8.546N·m

M_(1V) =-48.467N·m

M_1^(') =53.915N·m

M_1^('') =49.214N·m

αT_1 =18.983N·m

M_e^(') =57.160N·m

M_e^('') =49.214N·m

20mm>d_0 ≥15.113mm

安全

25mm>d_1 ≥21.685mm

安全

S=6.015>1.5

安全

S=18.669>1.5

安全

d_(min) =41mm

R_(VH) =-0.267kN

R_(VIH) =1.544kN

R_(VV) =-1.116kN

R_(VIV) =-2.252kN

M_(4H)^(') =-28.619N·m

M_(4H)^('') =81.857N·m

M_(4V) =-119.375N·m

M_4^(') =122.757N·m

M_4^('') =144.744N·m

αT_1 =219.762N·m

M_e^(') =122.757N·m

M_e^('') =263.147N·m

45mm>d_4 ≥36.303mm

危险截面处安全

S=5.16>1.5

安全

S=1.75>1.5

安全
| (4) 轴承的选择与校核

### 1. 中间轴轴承的选择与校核

### 2. 高速轴轴承的选择与校核

### 3. 低速轴轴承的选择与校核

对于角接触球轴承：

查[2]表14-7，取温度系数 K_t 为1；

查[2]表14-10，得 e=0.68；

查[2]表14-11，得AC型角接触球轴承 S=0.68R；

查[2]表14-9，取 K_P =1.1 。

球轴承 ε=3 ，寿命计算公式 L_(10h) =(10^6)/(60n_(II))(C/(P_(III)))^ε 。

选用角接触球轴承7207AC。

轴承处的径向载荷：

R_(III) =√(R_(IIIH) ^2 +R_(IIIV) ^2)=2283.8N

R_(IV) =√(R_(IVH) ^2 +R_(IVV) ^2)=2586.0N

则：

S_(III) =0.68R_(III) =1553.0N

S_(IV) =0.68R_(IV) =1758.5N

F_(IIa) =F_(a3) -F_(a2) =330N ,方向向左。

S_(IV) +F_(IIa) >S_(III) ，则 A_(III) =S_(IV) +F_a =2088.5N，A_(IV) =S_(IV) =1758.5N 。

(A_(III))/(R_(III))=0.91>e ，则 X_(III) =0.41,Y_(III) =0.87 ；

(A_(IV))/(R_(IV))=0.68=e ，则 X_(IV) =1,Y_(IV) =0 。

P_(III) =K_P (X_(III) R_(III) +Y_(III) A_(III) )=3028.7N

P_(IV) =K_P (X_(IV) R_(IV) +Y_(IV) A_(IV) )=2844.6N

查[2]表14-5得 C=22.50kN 。

轴承寿命：

L_(10hII) =(10^6)/(60n_(II))(C/(P_(III)))^ε =29823.9h

大修期三年，两班制总时间:

8×2×300×3=14400h<29823.9h

轴承寿命合格。

选用角接触球轴承7205AC。

轴承处的径向载荷：

R_I =√(R_(IH) ^2 +R_(IV) ^2)=1135.1N

R_(II) =√(R_(IIH) ^2 +R_(IIV) ^2)=401.8N

则：

S_I =0.68R_I =771.9N

S_(II) =0.68R_(II) =273.2N

F_(Ia) =F_(a1) =652N ,方向向右。

S_I +F_(Ia) >S_(II) ，则 A_I =S_I =771.9N，A_(II) =S_I +F_(Ia) =1423.9N 。

(A_I)/(R_I)=0.68=e ，则 X_I =1,Y_I =0 ；

(A_(II))/(R_(II))=3.54>e ，则 X_(II) =0.41,Y_(II) =0.87 。

P_I =K_P (X_I R_I +Y_I A_I )=1248.6N

P_(II) =K_P (X_(II) R_(II) +Y_(II) A_(II) )=1543.9N

查[2]表14-5得 C=12.20kN 。

轴承寿命：

L_(10hI) =(10^6)/(60n_I)(C/(P_I))^ε =16195.2h

大修期三年，两班制总时间:

8×2×300×3=14400h<16195.2h

轴承寿命合格。

选用角接触球轴承7209AC。

轴承处的径向载荷：

R_V =√(R_(VH) ^2 +R_(VV) ^2)=1147.3N

R_(VI) =√(R_(VIH) ^2 +R_(VIV) ^2)=2731.0N

则：

S_V =0.68R_V =780.2N

S_(VI) =0.68R_(VI) =1857.1N

F_(IIIa) =F_(a4) =982N ,方向向右。

S_V +F_(IIIa) <S_(VI) ，则 A_V =S_(VI) -F_(IIIa) =875.1N，A_(VI) =S_(VI) =1857.1N 。

(A_V)/(R_V)=0.76>e ，则 X_V =0.41,Y_V =0.87 ；

(A_(VI))/(R_(VI))=0.68>e ，则 X_(VI) =1,Y_(VI) =0 。

P_V =K_P (X_V R_V +Y_V A_V )=1354.9N

P_(VI) =K_P (X_(VI) R_(VI) +Y_(VI) A_(VI) )=3004.1N

查[2]表14-5得 C=28.20kN 。

轴承寿命：

L_(10hIII) =(10^6)/(60n_(III))(C/(P_(VI)))^ε =16195.2h

大修期三年，两班制总时间:

8×2×300×3=14400h<180522.0h

轴承寿命合格。

K_t =1

e=0.68

K_P =1.1

R_(III) =2283.8N

R_(IV) =2586.0N

S_(III) =1553.0N

S_(IV) =1758.5N

A_(III) =2088.5N

A_(IV) =1758.5N

P_(III) =3028.7N

P_(IV) =2844.6N

14400h<L_(10hII) =29823.9h

合格

R_I =1135.1N

R_(II) =401.8N

S_I =771.9N

S_(II) =273.2N

A_I =771.9N

A_(II) =1423.9N

P_I =1248.6N

P_(II) =1543.9N

14400h<L_(10hI) =16195.2h

合格

R_V =1147.3N

R_(VI) =2731.0N

S_V =780.2N

S_(VI) =1857.1N

A_V =875.1N

A_(VI) =1857.1N

P_V =1354.9N

P_(VI) =3004.1N

14400h<L_(10hIII) =16195.2h

合格
| (5) 键的选择和校核

### 1. 中间轴键的选择与校核

（1）中间轴键的选择

（2）中间轴键的校核

### 2. 高速轴键的选择与校核

（1）高速轴键的选择

（2）高速轴键的校核

### 3. 低速轴键的选择与校核

（1）低速轴键的选择

（2）低速轴键的校核

齿轮2处：

选择普通平键A型。

查[1]表8-61，选取各参数如下：

键宽 b | 12mm
键高 h | 8mm
键长 L | 28mm

齿轮3处：

选择普通平键A型。

查[1]表8-61，选取各参数如下：

键宽 b | 14mm
键高 h | 9mm
键长 L | 56mm

键的材料为钢，齿轮轮毂为锻钢，静载荷，查[2]表11-10，知，许用挤压应力 [σ_p ]=125~150MPa ，取 [σ_p ]=150MPa 。

传递转矩 T_2 =131.71N·m 。

计算长度： L_(C2) =L_2 -b_2 =16mm，L_(C3) =L_3 -b_3 =42mm 。

则：

σ_(p2) =(4T_2)/(dhL_(C2))=95.72MPa<[σ_p ]

σ_(p3) =(4T_2)/(dhL_(C3))=36.46MPa<[σ_p ]

强度满足要求。

联轴器处：

选择普通平键A型。

查[1]表8-61，选取各参数如下：

键宽 b | 6mm
键高 h | 6mm
键长 L | 40mm

键和联轴器的材料为钢，静载荷，查[2]表11-10，知，许用挤压应力 [σ_p ]=125~150MPa ，取 [σ_p ]=150MPa 。

传递转矩 T_1 =32.73N·m 。

计算长度： L_(C1) =L_1 -b_1 =34mm 。

则：

σ_(p1) =(4T_1)/(dhL_(C1))=32.09MPa<[σ_p ]

强度满足要求。

齿轮4处：

选择普通平键A型。

查[1]表8-61，选取各参数如下：

键宽 b | 16mm
键高 h | 10mm
键长 L | 56mm

联轴器处：

选择普通平键A型。

查[1]表8-61，选取各参数如下：

键宽 b | 10mm
键高 h | 8mm
键长 L | 45mm

键的材料为钢，齿轮轮毂为锻钢，静载荷，查[2]表11-10，知，许用挤压应力 [σ_p ]=125~150MPa ，取 [σ_p ]=150MPa 。

传递转矩 T_3 =378.9N·m 。

计算长度： L_(C4) =L_4 -b_4 =40mm，L_(C5) =L_5 -b_5 =32mm 。

则：

σ_(p4) =(4T_3)/(dhL_(C4))=71.49MPa<[σ_p ]

σ_(p5) =(4T_3)/(dhL_(C5))=146.29MPa<[σ_p ]

强度满足要求。

齿轮2处选择普通平键A型

齿轮3处选择普通平键A型

[σ_p ]=150MPa

σ_(p2) <[σ_p ]

σ_(p3) <[σ_p ]

强度满足要求

输入端联轴器处选择普通平键A型

[σ_p ]=150MPa

σ_(p1) <[σ_p ]

强度满足要求

齿轮4处选择普通平键A型

输出端联轴器处选择普通平键A型

[σ_p ]=150MPa

σ_(p4) <[σ_p ]

σ_(p5) <[σ_p ]

强度满足要求
| (6) 联轴器的选择和校核
1. 输入联轴器的选择和校核 2. 输出联轴器的选择和校核 | 输入轴选择的联轴器为LX2型弹性柱销联轴器（GB/T 5014-2003）,公称转矩为 560N.m ，许用转速 6300r/min ，联轴器的计算转矩： T_(c1) =K_A ·T_1 =49.10N·m<560N.m 电动机转速 960r/min 小于许用转速 6300r/min ，满足要求。 两端轴孔直径分别选择 38mm 及 20mm 。 输出轴选择的联轴器为GY6凸缘联轴器（GB/T 5843-2003）,公称转矩为 900N.m ，许用转速 6800r/min ，联轴器的计算转矩 T_(c2) =K_A ·T_3 =568.35N·m<900N.m 转速 76.37r/min 小于许用转速 6800r/min ，满足要求。 两端轴孔直径分别选择 38mm 及38 mm 。 | 输入轴LX2型弹性柱销联轴器 输出轴GY6凸缘联轴器
| (7) 箱体的设计

### 1. 箱体的结构型式

### 2. 箱体的结构分析

### 3. 箱体的结构尺寸

考虑到铸造箱体适宜成批生产，刚性好，易获得合理和复杂的外形，易于切削，减速器采用铸造箱体，材料为HT200。

箱体分为箱盖和箱座。箱座壁厚为 δ ，箱盖壁厚为 δ_1 。箱体内侧壁与齿轮两端面有间距 Δ2 ，与齿顶圆间距 Δ1 ，箱座底壁与大齿轮齿顶圆间距不小于 30~50mm ，按结构或油的容量确定(最好输入轴与电机轴同高以方便安装)。为使上下箱可靠地定位和联接，其接合面均向外做出一定厚度的凸缘，凸缘宽度由其联接螺栓的扳手空间决定。

为适应轴承宽度和安放轴承盖，在座孔周围箱壁外扩成具有一定宽度 L 的轴承座，并在轴承座两旁设置凸台结构，使联接螺栓能紧靠座孔以提高联接刚性。两旁的联接螺栓S在满足 S≈D2 （D2为轴承座外径）的基础上尽量靠近，但不能与油沟相通，以免漏油和油沟失去供油作用。凸台高度 h 应保证足够的扳手空间。由于轴承座间两凸台相距较近，因此用连成一片的结构，以免两凸台间形成狭缝结构使铸造砂型易碎裂，浇注时铁水难流进。

为使箱座与其他座架联接，箱座也需做出凸缘底座。箱座底面设计成矩形凸缘，凸缘宽度由地脚螺栓的扳手空间决定，并要求宽度超过箱座内壁位置。

为增加轴承座的刚性，轴承座处设计肋板结构，肋板厚度为壁厚的0.85倍。

减速器中的滚动轴承采用飞溅润滑时，需在箱座接合面上制出输油沟和作为接合面间密封用的回油沟。为保证密封性，接合面应精刨，且控制接合面联接螺栓的间距不大于 100~150mm ，并对称布置。

箱盖采用两圆弧及切线的形式，大齿轮所在一侧箱盖外表面的圆弧以大齿轮轴心为圆心，半径 R_2 =(d_(a4))/2+Δ1+δ1 。小齿轮所在一侧箱盖的外表面圆弧位于该处轴承座凸台以外的地方。

箱体还需在适当的部位设置检查孔，油面指示装置，通气器，排油孔，起吊装置等。

依据上述设计要求，参考[1]图4-52及[1]表4-6，结合实际情况，经过迭代与尝试，确定箱体各主要尺寸如下：

名称 | 符号 | 型式及尺寸（mm）
箱座壁厚 | δ | 8
箱盖壁厚 | δ_1 | 8
箱座、箱盖、箱座底凸缘厚度 | b、b_1 、b_2 | 12、12、20
地脚螺栓直径及数目 | d_f 、n | 14、6
轴承旁连接螺栓直径 | d_1 | 10.5
箱盖、箱座连接螺栓直径 | d_2 | 8
轴承端盖螺钉直径及数目 | d_3 | 8、10、10
检查孔盖螺钉直径 | d_4 | 8
d_f 、d_1 、d_2 至箱外壁距离 d_f 、d_2 至凸缘边缘距离 | c_1 c_2 | d_f d_1 d_2 20 16 14 18 14 12
轴承座外径 | D_2 | 92、112、120
轴承旁联接螺栓距离 | S | 98、135、139
轴承旁凸台半径 | R_1 | 14
轴承旁凸台高度 | h | 30
箱外壁至轴承座端面距离 | L_1 | 48
箱盖、箱座肋厚 | m_1 、m | 7、7
大齿轮顶圆与箱内壁间距离 | Δ1 | 9.6
齿轮端面与箱内壁距离 | Δ2 | 8

铸造斜度、过渡尺寸、铸造外圆角、内圆角等参数可参考[1]表8-9、8-10、8-11、8-12
| (8) 润滑和密封的选择
1. 润滑 （1） 齿轮的润滑 （2） 轴承的润滑 2. 密封 （1） 轴伸出处密封 （2） 箱盖与箱座接合面的密封 （3） 其他部位的密封 | 齿轮2圆周速度 v_2 =2.32m/s ，齿轮4圆周速度 v_4 =0.90m/s 。速度均在 0.5m/s~12m/s 的范围内，可采用浸油润滑；同时，速度小于 2.5m/s ，选用320工业闭式齿轮油。 查[1]表8-167，得润滑油参数： 运动粘度 288 ~ 352 粘度指数 90 闪点 200℃ 倾点 -8 ℃ 为了使高速级和低速级大齿轮都达到足够的浸油深度，用挡板隔开两级大齿轮，分开浸油润滑，两级大齿轮的浸油深度均为 10mm 。 v_2 =2.32m/s>2m/s ，采用飞溅润滑。为使润滑可靠，在箱座接合面上制出输油沟。在箱盖内壁与其接合面处制出倒棱，以便于油液流入油沟。输油沟尺寸： a=5mm ， b=6mm 。 选择毡圈式密封。利用矩形截面的毛毡圈嵌入梯形槽中所产生的对轴的压紧作用，获得防止润滑油漏出和外界杂志灰质等侵入轴承室的密封效果。 参考[1]表8-173，可得毡圈相关尺寸： 高速轴轴径 20mm ，则毡圈外径 D=33mm ,毡圈内径 d_1 =19mm ，毡圈宽度 B=6mm ，沟槽外径 D_0 =32mm ，沟槽内径 d_0 =21mm ，沟槽宽度 b=5mm ，密封处宽度 δ=12mm 。 低速轴轴径 38mm ，对应 D=49mm ， d_1 =34mm ， B=7mm ， D_0 =48mm ， d_0 =36mm ， b=6mm ， δ=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 | 齿轮浸油润滑 选用320工业闭式齿轮油 用挡板隔开两级大齿轮，分开浸油润滑 轴承飞溅润滑 在箱座接合面上制出输油沟 毡圈式密封 箱盖与箱座接合面涂密封胶密封 其它接合面加纸封油垫
| (9) 附件及说明

### 1. 轴承盖

(1) 结构
（2） 尺寸

### 2. 调整垫片组

（1） 结构

（2） 尺寸

### 3. 油标

### 4. 排油孔螺塞

### 5. 检查孔盖版

### 6. 通气器

### 7. 起吊装置

### 8. 定位销

### 9. 起盖螺钉

轴承盖的结构型式为螺钉联接式，并且设计透盖和闷盖。材料为HT150。其中透盖的结构如下图所示：

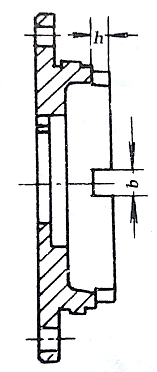
[picture p25: figure]
屏幕剪辑

闷盖与透盖相比，区别在于盖中心没有透孔，其余结构相同。

中间轴：

轴承外径 D | 72mm
轴承盖联接螺钉直径 d_3 | 10mm
轴承盖螺钉孔直径 d_0 | 11mm
轴承盖螺钉孔中心距 D_0 | 97mm
轴承盖外径 D_2 | 122mm
轴承盖顶住轴承处的内径 D_4 | 62mm
轴承盖板宽度 e | 12mm
密封处宽度 b | 8mm
油沟高度 h | 8mm

高速轴：

D | 52m
d_3 | 8mm
d_0 | 9mm
D_0 | 72mm
D_2 | 92mm
D_4 | 42mm
e | 9.6mm
b | 8mm
h | 8mm

低速轴：

D | 85m
d_3 | 10mm
d_0 | 11mm
D_0 | 110mm
D_2 | 135mm
D_4 | 75mm
e | 12mm
b | 10mm
h | 10mm

调整垫片组的作用为调整轴承游隙及支承的轴向位置。垫片组由若干种厚度的垫片根据需要调整的厚度叠合而成，材料选为08F钢抛光。

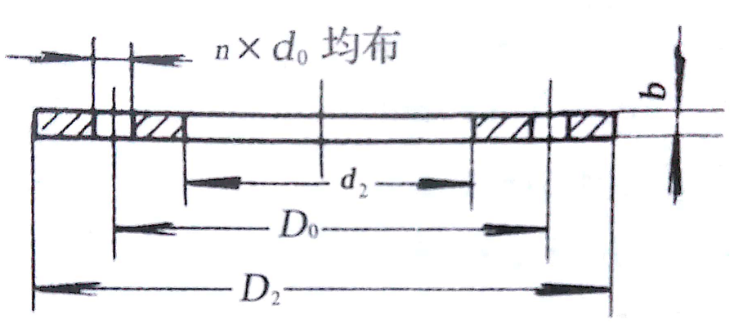
[picture p26: figure]
屏幕剪辑

参考[1]表4-9，选择A组，调整垫片厚度0.5mm的片数为3，厚度0.2mm的片数为4，厚度0.1mm的片数为2。

调整垫片组内径 d_2 =D+(2~4)mm ，其中D为轴承外径，其余尺寸与轴承盖相同，则：

高速轴 d_2 =54mm ；中间轴 d_2 =74mm ；低速轴 d_2 =87mm 。

游标用来指示箱内油面高度，选用杆式游标M12（16H9/d9）。结构尺寸如图：

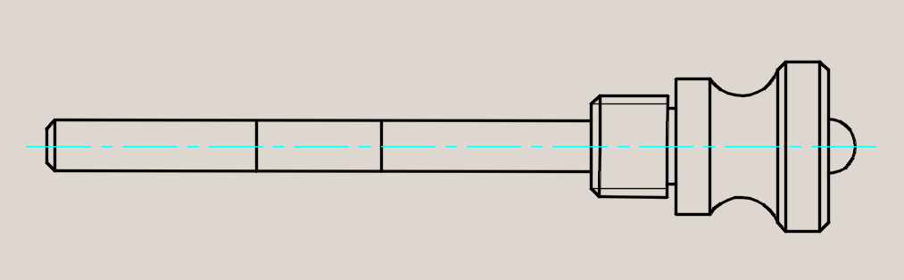
[picture p27: figure]
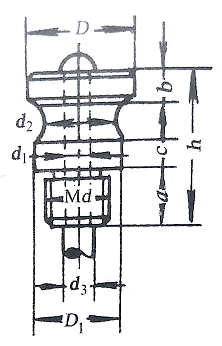
[picture p28: figure]
屏幕剪辑

相关尺寸如下表：

d_1 | d_2 | d_3 | h | a | b | c | D | D_1
4 | 12 | 6 | 28 | 10 | 6 | 4 | 20 | 16

单位为mm。

在箱座底部设排油孔，用于换油及清洗箱体时排出油污。平时排油孔用螺塞及封油垫封住。排油孔螺塞采用Q235，封油垫采用石棉橡胶纸。排油孔螺塞及封油垫尺寸参考[1]表4-13。

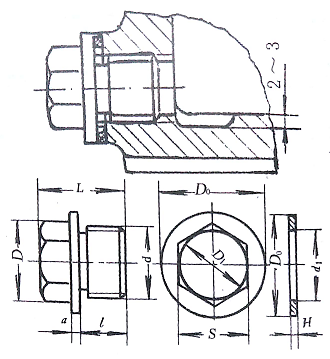
[picture p29: figure]
屏幕剪辑

螺塞选用M20×1.5。其余相关尺寸如下：

D_0 | 30
L | 28
l | 15
a | 4
D | 25.5
S | 22
D_1 | 20.9
d_1 | 22
H | 3

单位为mm。

检查传动件啮合情况、润滑状态及向箱内注油，在箱盖上部便于观察传动件啮合区的位置开足够大的检查孔，平时则将检查孔盖板盖上并用螺钉予以固定，盖板与箱盖凸台接合面间加装防渗漏的石棉橡胶纸。

盖板材料选择Q215。螺钉选用M8，检查孔及其盖板的结构尺寸参考[1]表4-14，如图：

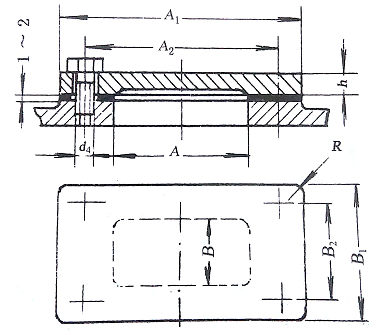
[picture p30: figure]
屏幕剪辑

相关尺寸：

A | 150mm
A1 | 198mm
A2 | 174mm
B1 | 166mm
B | 118mm
B2 | 142mm
d4 | 8mm
R | 5mm
h | 8mm

为沟通箱体内外的气流使箱体内的气压不会因为减速器运转时的温升而增大，从而造成减速器密封处渗漏，在箱盖顶部或检查孔盖板上安装通气器。通气器结构尺寸如图所示：

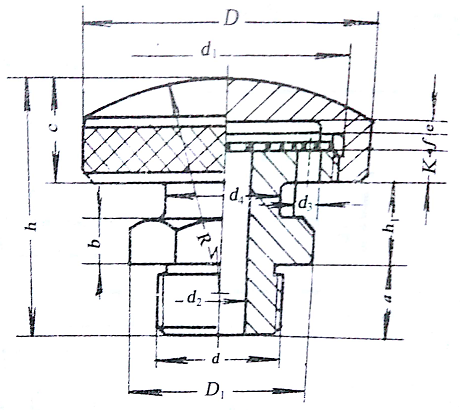
[picture p31: figure]
屏幕剪辑

相关尺寸：

d | d_1 | | d_2 | d_3 | d_4 | h | D | a
M24 | M48×1.5 | | 12 | 5 | 22 | 50 | 55 | 15
b | c | h_1 | R | D_1 | S | K | e | f
8 | 20 | 22 | 60 | 36.9 | 32 | 7 | 2 | 2

单位为mm，其中S为扳手宽度。

在箱盖上铸出吊耳和吊耳环，用来起吊箱盖。

吊钩形状及尺寸如下：

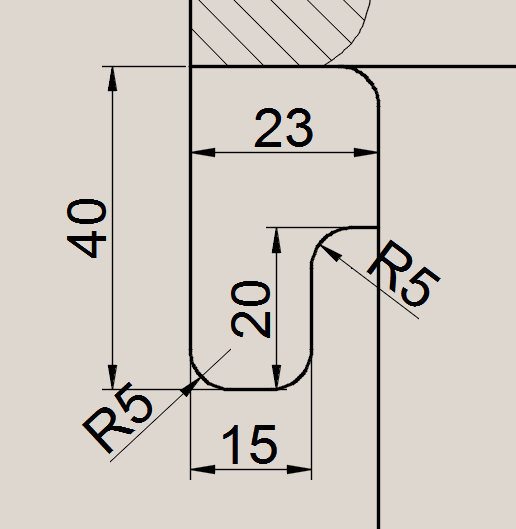
[picture p32: figure]
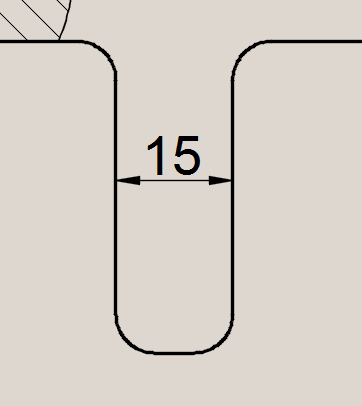
[picture p33: figure]

吊耳环形状及尺寸如下：

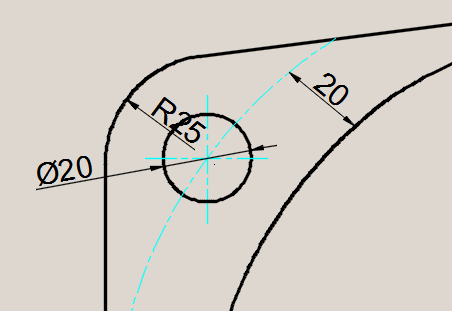
[picture p34: figure]
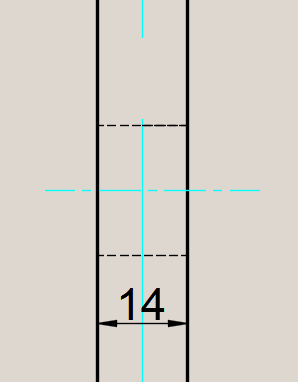
[picture p35: figure]

定位销用来确定箱座与箱盖的相互位置。为保证轴承座孔的镗孔精度与装配精度，在箱体的联接凸缘上距离尽量远处安置两个定位销，并设置在不对称的位置。选择圆锥销作为定位销，公称直径 d=(0.7-0.8)d_2 , d_2 为箱座、箱盖凸缘联接螺栓直径，选择 d_2 =8mm ，则取 d=6mm 。长度稍大于箱体联接凸缘的总厚度，以利拆装，取长度为 26mm 。数量2个对角布置。定位销孔是在箱盖和箱座剖分面加工完毕并用螺栓固联后进行配钻和配绞的。

起盖螺钉选择M10，数目1只。螺纹长度大于箱盖凸缘厚度，取长度为16mm，钉杆端部制成直径较细的圆柱端，以免经常拧动时损坏杆端螺纹。起盖螺钉材料为35号钢并通过热处理使硬度达28-38HRC。

选用螺钉联接式轴承盖

选择A组调整垫片

选用杆式游标M12

排油孔螺塞M20×1.5

起盖螺钉M10， 1只

# 4、 设计小结

从设计到计算，从计算到绘图，从绘图到校核，这不是一个线性的过程，一个实际的机械设计项目很可能是需要不断迭代的。在最初我想过能不能把整个的设计流程抽象出来，整理成一份代码，这样我只需要输入想要的机构特性，程序就可以自动完成设计、校核甚至建模绘图的工作，这个模型不需要非常精确，即使有一些瑕疵，我也可以在它的基础上再进行后续处理，这样还是会大大简化我的工作（以及之后所有需要设计减速器的人的工作： ） ）。但是实践证明，这个目标似乎并不那么好达到。一开始我以为只需要将关系式写出来，再把相关标准里面的规定参数录入，剩下的问题无非是多种结构尺寸的排列组合，而这种大量的无脑计算正是计算机所擅长的。但是，我发现这个系统中所含的关系式似乎是高度耦合的，不同变量之间的关系并不是单向的，因此抽象难度大大提升。考虑到时间成本，我只好放弃这个想法，老老实实手动“搬砖”。虽然想法失败了，但是我注意到参考资料[1]中提到了一种叫做“外点混合罚函数法”的方法，正好可以解决我遇到的参数耦合程度太大的问题。本质上减速器设计就是在给出一定条件（材料许用极限、标准限定系数等）的前提下，求这个系统的最优解——体积小、寿命长、安全性好等等，也就是一个最优化问题。做出一个减速器通用的设计方法，这个目标很大，但不是遥不可及，我希望以后有机会还可以研究一下，。

具体在本次机械设计训练中，我也收获了很多有意义的经验。这是我第一次将所学的机械设计知识综合运用到实际项目中来，才知道纸上得来终觉浅。归纳起来，大概有以下几点粗浅的认识：

1. 对系统中起到主要作用的机构要谨慎设计，要考虑到它对之后整个系统设计的巨大影响。如减速器中的轴系，必须合理安排轴及齿轮的位置关系；
2. 在设计初期，多画草图是一个很明智的做法，在草图中发现问题、不断修改，会避免之后绘图与校核时再出现比较大的问题
3. 对不太清楚的零件尺寸，要多查阅相关标准，基本上所有尺寸都有对应的标准存在，在一开始按照标准处理会避免之后再回来修改；
4. 掌握一定的CAD制图技巧很重要，无论是平面图还是三维图，AutoCAD、SolidWorks等工程软件中都有很多可以大幅提高工作效率的技巧；

# 5、 参考资料

[1].陈秀宁、施高义.机械设计课程设计[M].第四版.杭州.浙江大学出版社.2012

[2].陈秀宁、顾大强.机械设计[M].第一版.杭州.浙江大学出版社.2010

# 6、 附录——MATLAB绘图代码

## 1. 水平弯矩图生成代码

%% 高速轴

plot([0 73.5 73.5+37.5 73.5+37.5 73.5+37.5+122.5], [0 0 23.619 8.546 0], '.-k', 'LineWidth',2)

patch([0 73.5 73.5+37.5 73.5+37.5 73.5+37.5+122.5], [0 0 23.619 8.546 0], [0.76 0.76 0.76])

text(120, 23, 'MH1''', 'FontSize', 20)

text(120, 8, 'MH1''''', 'FontSize', 20)

%% 中间轴

plot([0 37.5 37.5 37.5+69.5 37.5+69.5 37.5+69.5+53], [0 -23.019 40.148 -41.921 -5.096 0], '.-k', 'LineWidth',2)

patch([0 37.5 37.5 37.5+69.5 37.5+69.5 37.5+69.5+53], [0 -23.019 40.148 -41.921 -5.096 0], [0.76 0.76 0.76])

text(40, -27, 'MH2''', 'FontSize', 20)

text(40, 40, 'MH2''''', 'FontSize', 20)

text(110, -8, 'MH3''', 'FontSize', 20)

text(110, -40, 'MH3''''', 'FontSize', 20)

%% 低速轴

plot([0 107 107 107+53 107+53+78], [0 -28.619 81.857 0 0], '.-k', 'LineWidth',2)

patch([0 107 107 107+53 107+53+78], [0 -28.619 81.857 0 0], [0.76 0.76 0.76])

text(110, -30, 'MH4''', 'FontSize', 20)

text(110, 85, 'MH4''''', 'FontSize', 20)

## 2. 垂直弯矩图生成代码

%% 高速轴

plot([0 73.5 73.5+37.5 73.5+37.5+122.5], [0 0 -48.467 0], '.-k', 'LineWidth',2)

patch([0 73.5 73.5+37.5 73.5+37.5+122.5], [0 0 -48.467 0], [0.76 0.76 0.76])

text(110, -47, 'MV1', 'FontSize', 20)

%% 中间轴

plot([0 37.5 37.5+69.5 37.5+69.5+53], [0 82.492 136.964 0], '.-k', 'LineWidth',2)

patch([0 37.5 37.5+69.5 37.5+69.5+53], [0 82.492 136.964 0], [0.76 0.76 0.76])

text(26, 83, 'MV2', 'FontSize', 20)

text(110, 135, 'MV3', 'FontSize', 20)

%% 低速轴

plot([0 107 107+53 107+53+78], [0 -119.375 0 0], '.-k', 'LineWidth',2)

patch([0 107 107+53 107+53+78], [0 -119.375 0 0], [0.76 0.76 0.76])

text(110, -115, 'MV4', 'FontSize', 20)

## 3. 合成弯矩图生成代码

%% 高速轴

plot([0 73.5 73.5+37.5 73.5+37.5 73.5+37.5+122.5], [0 0 52.770 48.022 0], '.-k', 'LineWidth',2)

patch([0 73.5 73.5+37.5 73.5+37.5 73.5+37.5+122.5], [0 0 52.770 48.022 0], [0.76 0.76 0.76])

text(110, 55, 'M1''', 'FontSize', 20)

text(110, 47, 'M1''''', 'FontSize', 20)

%% 中间轴

plot([0 37.5 37.5 37.5+69.5 37.5+69.5 37.5+69.5+53], [0 85.643 91.742 143.236 137.059 0], '.-k', 'LineWidth',2)

patch([0 37.5 37.5 37.5+69.5 37.5+69.5 37.5+69.5+53], [0 85.643 91.742 143.236 137.059 0], [0.76 0.76 0.76])

text(40, 85, 'M2''', 'FontSize', 20)

text(40, 100, 'M2''''', 'FontSize', 20)

text(110, 130, 'M3''', 'FontSize', 20)

text(110, 145, 'M3''''', 'FontSize', 20)

%% 低速轴

plot([0 107 107 107+53 107+53+78], [0 122.757 144.744 0 0], '.-k', 'LineWidth',2)

patch([0 107 107 107+53 107+53+78], [0 122.757 144.744 0 0], [0.76 0.76 0.76])

text(78, 140, 'M4''', 'FontSize', 20)

text(78, 120, 'M4''''', 'FontSize', 20)

## 4. 扭矩图生成代码

%% 高速轴

plot([0 0 73.5+37.5 73.5+37.5 73.5+37.5+122.5], [0 32.73 32.73 0 0], '.-k', 'LineWidth',2)

patch([0 0 73.5+37.5 73.5+37.5 73.5+37.5+122.5], [0 32.73 32.73 0 0], [0.76 0.76 0.76])

text(115, 33, 'aT1', 'FontSize', 20)

%% 中间轴

plot([0 37.5 37.5 37.5+69.5 37.5+69.5 37.5+69.5+53], [0 0 131.71 131.71 0 0], '.-k', 'LineWidth',2)

patch([0 37.5 37.5 37.5+69.5 37.5+69.5 37.5+69.5+53], [0 0 131.71 131.71 0 0], [0.76 0.76 0.76])

text(110, 130, 'aT2', 'FontSize', 20)

%% 低速轴

plot([0 107 107 107+53+78 107+53+78], [0 0 378.9 378.9 0], '.-k', 'LineWidth',2)

patch([0 107 107 107+53+78 107+53+78], [0 0 378.9 378.9 0], [0.76 0.76 0.76])

text(80, 375, 'aT3', 'FontSize', 20)

## 5. 当量弯矩图生成代码

%% 高速轴

plot([0 0 73.5 73.5+37.5 73.5+37.5 73.5+37.5+122.5], [0 18.983 18.983 57.160 49.214 0], '.-k', 'LineWidth',2)

patch([0 0 73.5 73.5+37.5 73.5+37.5 73.5+37.5+122.5], [0 18.983 18.983 57.160 49.214 0], [0.76 0.76 0.76])

text(115, 58, 'Me1''', 'FontSize', 20)

text(115, 45, 'Me1''''', 'FontSize', 20)

%% 中间轴

plot([0 37.5 37.5 37.5+69.5 37.5+69.5 37.5+69.5+53], [0 114.763 119.383 162.334 156.910 0], '.-k', 'LineWidth',2)

patch([0 37.5 37.5 37.5+69.5 37.5+69.5 37.5+69.5+53], [0 114.763 119.383 162.334 156.910 0], [0.76 0.76 0.76])

text(40, 110, 'Me2''', 'FontSize', 20)

text(40, 125, 'Me2''''', 'FontSize', 20)

text(110, 150, 'Me3''', 'FontSize', 20)

text(110, 165, 'Me3''''', 'FontSize', 20)

%% 低速轴

plot([0 107 107 107+53 107+53+78 107+53+78], [0 122.757 263.147 219.762 219.762 0], '.-k', 'LineWidth',2)

patch([0 107 107 107+53 107+53+78 107+53+78], [0 122.757 263.147 219.762 219.762 0], [0.76 0.76 0.76])

text(115, 130, 'Me4''', 'FontSize', 20)

text(89, 273, 'Me4''''', 'FontSize', 20)
