XinArkh/Machine_Design_Project/(list of files, cad)

Other CAD files:
AutoCAD/装配图/装配图-A0.dwg
AutoCAD/连接器行业标准A4图框.dwg
AutoCAD/零件图/轴.dwg
SolidWorks/减速器轴草图.SLDPRT
AutoCAD/装配图/装配图草图-A4.dwg
AutoCAD/零件图/零件图-输出轴.dwg
AutoCAD/装配图/装配图-草图.DWG
AutoCAD/零件图/零件图-输出轴齿轮.dwg
