XinArkh/Machine_Design_Project/(commit log)

2018-04-05 机械设计课程设计作业 - 减速器设计
    [减速器轴结构设计校核.xlsx]
2018-04-08 三个轴校核完毕
    [减速器轴结构设计校核.xlsx]
2018-04-09 星期一白天上课做的
    [减速器轴草图.SLDPRT, 装配图.DWG]
2018-04-09 星期一下午及晚上做的
    [减速器轴结构设计校核.xlsx, 装配图.DWG]
2018-04-10 星期二上午做的
    [装配图.DWG]
2018-04-10 星期二晚上做的
    [装配图.DWG]
2018-04-11 星期三下午及晚上做的
    [装配图-副本.dwg, 装配图.DWG]
2018-04-11 A4标准图幅
    [连接器行业标准A4图框.dwg]
2018-04-12 星期四晚上做的
    [装配图-A0大小.dwg, 装配图-A4大小.dwg, 装配图.DWG]
2018-04-13 终于画完A0装配图；下一步零件图
    [装配图-A0大小.dwg]
2018-04-14 星期六上午：无所事事，没什么进展
    [装配图-A0.dwg, 装配图-A0大小.dwg, 装配图-A4大小.dwg, 装配图-草图.DWG, 装配图草图-A4.dwg, 零件图-输出轴.dwg]
2018-04-14 星期六下午+半个晚上：<完成>输出轴零件图
    [减速器轴结构设计校核.xlsx, 减速器轴草图.SLDPRT, 装配图-A0.dwg, 装配图-草图.DWG, 装配图草图-A4.dwg, 连接器行业标准A4图框.dwg, 零件图-输出轴.dwg]
2018-04-15 星期日下午+半个晚上：齿轮零件图基本画完
    [装配图-A0.dwg, 零件图-输出轴.dwg, 零件图-输出轴齿轮.dwg]
2018-04-18 更新：零件图转为pdf格式后，技术要求文字无法显示，重新贴一遍文字解决
    [零件图-输出轴.dwg, 零件图-输出轴齿轮.dwg]
2018-04-23 写设计说明书，拆分三个轴的视图，略微调整尺寸
    [减速器轴结构设计校核.xlsx, 轴.dwg]
2018-04-23 装配图小幅度修改
    [装配图-A0.dwg]
2018-04-24 星期二的
    [减速器轴结构设计校核.xlsx, 装配图-A0.dwg, 零件图-输出轴.dwg]
2018-04-25 星期三上午
    [装配图-A0.dwg, 轴.dwg]
